fablabnbg/Innentueren/TechSpec/TechSpec_Innentueren.odt

FabLab Region Nürnberg

Innentüren

TechSpec

Changelog
Datum | Verfasser | Änderung
16.01.2019 | Roman | Erstentwurf
24.01.2019 | Mose, Gerhard, Schimmi | Änderungsvorschläge
31.01.2019 | Roman | Glattziehen des Kapitels Türmodul, Umzug ins Git

Synonym | Erklärung
Türserver | Der Rechner, welcher über die Türmodule mit den Lesereinheiten und dem Türöffner kommuniziert.
Türmodul | Die Hardware-Schnittstelle zwischen den Lesegeräten an der Tür und dem Türserver.
Lesereinheit | Die Elektronik an der Tür, welche die Karte einliest und mit dem Türmodul kommuniziert.
Türöffner | Oder auch Summer. Die elektromechanische Verriegelung der Tür.

1. Hardware
  1. Türmodul

Die gewählte Schnittstelle für die Innentüren ist UART. Da dies eine Punkt-zu-Punkt Verbindung ist, muss ein UART Hub eingesetzt werden, damit der Türserver mit begrenzten Schnittstellen auch mit allen Innentüren kommunizieren kann. Es wurde sich daher für eine 4er Granularität mit Hilfe des FTDI FT4232H Chips entschieden. Dieser Chip kann 4 UART Schnittstellen auf einen USB umsetzen.

Alle Module kommen in einem 19“ Rack unter und haben Eurokarten-Format (160x 100mm).

Die Backplane besteht aus DIN 41612 konformen Steckern. Die Stecker weisen 32 Pole auf (2 x 16 Pins).

Die Innentüren, der Server, die 4er Module sowie die Stromversorgung werden über diese Rückwand verteilt.

Es wird eine zusätzliche Platine für die Türmodul Frontplatte designed. Diese wird die LEDs und die Schalter mit der Hauptplatine verbinden. Die Verbindung wird über zwei 50-polige Wannenstecker (jeweils einer auf jeder Platine) und einem Breitbandkabel hergestellt.

Es werden pro Tür folgende Features benötigt:

- Status-LED für
  - TX
  - RX
  - Türöffner
  - Magnetkontakt
  - 5V Fuse OK LED für Logik Versorgungsspannung
  - 12V Fuse OK LED für Türöffner Versorgungsspannung
- Sicherungen
  - 5V (Logik)
  - 12V (Türöffner)
- Bedienelemente
  - Schalter „Ein-Aus-Ein“: Modi „Auto-Aus-Dauer Ein“, Ausführung Wechsler

Es werden pro Modul folgende Features benötigt:

- Status-LED für:
  - Modul Fehler (12V oder 5V Sicherung defekt)
  - 5V Spannungsversorgung Modul
  - 12V Spannungsversorgung Modul

Die RTS Leitung des jeweiligen UARTS steuert high-aktiv P-MOSFETs, die als High-Side Schalter eingesetzt werden. Auch die Freilaufdiode für den Türöffner wird auf der Platine vorgesehen. Während des Hochlaufs werden die RTS Leitungen durch den Power-Enable (früher UID) Pin auf GND gezogen. Beim Start der Innentüren-Applikation auf dem Türserver wird der Power-Enable GPIO Pin auf low geschaltet, somit werden die RTS Leitungen freigegeben.

Der Türöffner wird über die CTS Leitung seines UART Ports gesteuert.

Der Magnetkontakt kann über die CTS Leitung seines UARTs ausgelesen werden. Ein high Pegel bedeutet dabei „Tür offen“, low dementsprechend „Tür zu“.

Im Falle eines Ausfalls des Türservers müssen die Türen weiterhin zugänglich gemacht werden können. Über den beschriebenen 3 Wege Schalter können die einzelnen Türöffner dauerhaft bestromt, abgeschaltet oder in den Automatikmodus ( Normal ) geschalten werden.

Türserver (Review bitte von Schimmi, Gerhard oder Mose anfertigen.)

Als Türserver wird ein Raspberry Pi (Modell ?) verwendet, der ebenfalls auf eine Europakarte im Einschubmodul montiert wird. Versorgungsspannung und Interfaceleitungen erfolgen über den Backplane Bus, der Ethernetanschluß kommt auf die Frontplatte.

Der Server muss auch ohne Netzwerkverbindung booten können und die volle Funktionalität der Türzentrale bereitstellen, dann ggf. mit einem älteren Stand der Zugangsberechtigungen.

Nach einem regulären Boot (oder Reset) wird zunächst ein Health-Check der angeschlossenen Türmodule und Türeinheiten durchgeführt. Dann wird versucht den aktuellen Stand der Zugangsberechtigungen von einem Server (bitte näher definieren!) abzuholen; schlägt dies fehl geht der Server mit dem vorhandenen Stand in Betrieb.

Der Betriebszustand wird über eine LED an der Frontplatte signalisiert.

Durch einen Taster an der Frontplatte kann ein Reset ausgelöst werden.

Durch einen weiteren Taster an der Frontplatte kann ein Health-Check getriggert werden.

Taster für Reboot ?

Config-File: Die Zugangsberechtigungen werden aus einem Config-File gelesen. Das ist eine Matrix aus Kartennummern und Türstationen. Neben den Zugangsberechtigungen muss in diesem Config-File (oder einem anderen?) auch die vorhandene Hardware hinterlegt sein, also wie viele Türmodule existieren, und welche Türschnittstellen je Modul belegt sind.

Health-Check: Hier wird auf Vorhandensein und Basis-Funktion der laut Config-File zu existierenden Komponenten getestet.

Step 1: USB-Kommunikation mit den 1 – n Türmodulen. Hier könnte z.B. die UID-LED am Türmodul angesprochen werden. (Bitte näher spezifizieren!)

Step 2: UART-Kommunikation mit den Lesereinheiten, die der Reihe nach angesprochen werden und im einfachsten Fall mit „ich bin da“ antworten. (Bitte näher spezifizieren!)

Wenn alles funktioniert leuchtet anschließend eine grüne LED an der Frontplatte, die bleibt auch im Normalbetrieb an.

Wenn in einem Step ein Fehler auftritt blinkt eine rote LED.

Wie der Bediener dann herausfindet, was genau fehlgeschlagen ist wäre noch zu klären.

Türserver Hardware: Optional könnten wir den Raspi mit einer SSD (mit USB-SATA Adapter) ausstatten und uns damit von den fehleranfälligen MicroSD Karten unabhängig machen. Sollten wir bei der mechanischen Konzeption des Türserver-Moduls bereits vorsehen.

Alternativ USB-Memorystick. Micro-SD Karte Read only. Datenbank kann bei Fehlern des R/W-Speichers solangen Sie vom Netz geholt werden kann in Ramdisk abgelegt werden.

Schreiben auf die Micro-SD-Karte maximal verhindern.

Lesereinheit (Review bitte von Schimmi anfertigen)

An jeder Tür befindet sich eine Lesereinheit bestehend aus:

• RFID-Kartenleser
• Türöffner
• Magnetkontakt (Tür geschlossen?)
• LED zur Betriebsanzeige (Vcc)
• RGB LED zur Statusanzeige
• Lautsprecher ~~Buzzer~~ für Audiofeedback
• CPU zur UART-Kommunikation (vermutlich Arduino?)

Bis auf den Türöffner (und Magnetkontakt?) sollten alle Komponenten eine kompakte Einheit bilden die leicht zu montieren und austauschen ist.

Alle Lesereinheiten sind identisch und beinhalten keine türspezifischen Komponenten oder Konfigurationen (DIP-Switches, Jumper o.ä.).

Die Verkabelung zur Lesereinheit erfolgt mit CAT-7 Verlegekabel, ein Aderpäarchen ist für den Türöffner reserviert. Anschluss und Position des Magnetkontaktes ist noch zu definieren.

Weitere Spezifikation muss noch durch Schimmi2 erfolgen.

Bitte auch die Blockschaltbilder für Türmodul und Lesereinheit unter https://oc.fablab-nuernberg.de/index.php/apps/files/?dir=/_intern/Projekte/000208-Innentueren/Türmodul/ (https://oc.fablab-nuernberg.de/index.php/apps/files/?fileid=302718)TechInfo&fileid=302718 (https://oc.fablab-nuernberg.de/index.php/apps/files/?fileid=302718) mit Kommentaren versehen, ich aktualisiere die dann entsprechend.
