fablabnbg/Innentueren/CAD/Tuermodul/Tuermodul.ods

Sheet: Tuermodul_bearbeitet
Source: | C:\Users\Roman\Dropbox\Projekte\FabLab\Innentueren\Innentueren\CAD\Tuermodul\Tuermodul.sch
Date: | 31.03.2019 16:09
Tool: | Eeschema (5.0.2)-1
Generator: | C:\Program Files\KiCad\bin\scripting\plugins/bom_csv_grouped_by_value.py
Component Count: | 176
 | Farb-Legende
 |  | Haben wir im Lab
 |  | Haben wir evtl.
 |  | Müssen wir bestellen
Item | Qty | Reference(s) | Value | LibPart | Footprint
1 | 2 | C101, C102 | 1u | Device:CP_Small | Capacitor_THT:CP_Radial_D5.0mm_P2.00mm |  | gefunden
2 | 14 | C103, C108, C110, C111, C112, C113, C114, C115, C116, C117, C118, C119, C120, C121 | 100n | Device:C_Small | Capacitor_SMD:C_0603_1608Metric_Pad1.05x0.95mm_HandSolder
3 | 2 | C104, C105 | 27p | Device:C_Small | Capacitor_SMD:C_0603_1608Metric_Pad1.05x0.95mm_HandSolder
4 | 1 | C106 | 3u3 | Device:C_Small | Capacitor_SMD:C_0805_2012Metric_Pad1.15x1.40mm_HandSolder
5 | 2 | C107, C109 | 4u7 | Device:CP_Small | Capacitor_THT:CP_Radial_D5.0mm_P2.50mm |  | gefunden
6 | 4 | D201, D202, D203, D204 | 1N4007 | Diode:1N4007 | Diode_THT:D_DO-41_SOD81_P10.16mm_Horizontal |  | gefunden
7 | 10 | D205, D206, D207, D208, D209, D210, D211, D212, D213, D214 | 1N4148 | Device:D_Small | Diode_THT:D_DO-41_SOD81_P7.62mm_Horizontal |  | gefunden
8 | 23 | D301, D303, D304, D305, D307, D308, D309, D311, D312, D313, D315, D316, D317, D319, D320, D321, D322, D323, D324, D325, D326, D327, D328 | rt | Device:LED_Small | LED_THT:LED_D3.0mm |  | gefunden
9 | 4 | D306, D310, D314, D318 | gn | Device:LED_Small | LED_THT:LED_D3.0mm |  | gefunden
10 | 4 | F201, F202, F203, F204 | 1A | Device:Fuse_Small | Fuse:Fuseholder_Cylinder-5x20mm_Schurter_0031_8201_Horizontal_Open
11 | 4 | F205, F206, F207, F208 | 0.5A | Device:Fuse_Small | Fuse:Fuseholder_Cylinder-5x20mm_Schurter_0031_8201_Horizontal_Open
12 | 1 | J101 | Conn_02x16_Counter_Clockwise | Connector_Generic:Conn_02x16_Counter_Clockwise | DIN41612_Connectors_custom:DIN41612_D_32pol_90deg |  | gefunden
13 | 1 | J201 | Conn_02x20_Odd_Even | Connector_Generic:Conn_02x20_Odd_Even | Connector_PinSocket_2.54mm:PinSocket_2x20_P2.54mm_Vertical_SMD
14 | 4 | J202, J203, J204, J205 | Conn_02x01 | Connector_Generic:Conn_02x01 | Connector_PinHeader_2.54mm:PinHeader_2x01_P2.54mm_Vertical |  | gefunden
15 | 1 | J301 | Conn_02x20_Counter_Clockwise | Connector_Generic:Conn_02x20_Odd_Even | Connector_PinSocket_2.54mm:PinSocket_2x20_P2.54mm_Vertical_SMD
16 | 2 | L101, L102 | 600R/0.5A | Device:L_Core_Ferrite_Small | Inductor_SMD:L_0603_1608Metric_Pad1.05x0.95mm_HandSolder
17 | 9 | Q205, Q206, Q207, Q208, Q213, Q214, Q215, Q216, Q301 | Q_NPN_CBE | Device:Q_NPN_CBE | Package_TO_SOT_THT:TO-92_HandSolder
18 | 4 | Q209, Q210, Q211, Q212 | Q_PMOS_GDS | Device:Q_PMOS_GDS | Package_TO_SOT_THT:TO-220-3_Vertical
19 | 19 | R101, R120, R121, R122, R123, R206, R207, R208, R214, R215, R216, R217, R220, R221, R223, R225, R226, R301, R304 | 1k | Device:R_Small | Resistor_SMD:R_0603_1608Metric_Pad1.05x0.95mm_HandSolder |  | gefunden
20 | 1 | R102 | 12k | Device:R_Small | Resistor_SMD:R_0603_1608Metric_Pad1.05x0.95mm_HandSolder |  | gefunden
21 | 5 | R103, R115, R117, R119, R205 | 10k | Device:R_Small | Resistor_SMD:R_0603_1608Metric_Pad1.05x0.95mm_HandSolder |  | gefunden
22 | 8 | R104, R105, R107, R108, R110, R111, R113, R114 | 33R | Device:R_Small | Resistor_SMD:R_0603_1608Metric_Pad1.05x0.95mm_HandSolder |  | gefunden
23 | 4 | R106, R109, R112, R118 | 100R | Device:R_Small | Resistor_SMD:R_0603_1608Metric_Pad1.05x0.95mm_HandSolder |  | gefunden
24 | 1 | R116 | 2k | Device:R_Small | Resistor_SMD:R_0603_1608Metric_Pad1.05x0.95mm_HandSolder |  | gefunden
25 | 4 | R201, R202, R203, R204 | 1k | Device:R_Small | Resistor_THT:R_Axial_DIN0207_L6.3mm_D2.5mm_P7.62mm_Horizontal |  | gefunden | 0,25W
26 | 4 | R209, R210, R211, R212 | 100k | Device:R_Small | Resistor_THT:R_Axial_DIN0207_L6.3mm_D2.5mm_P7.62mm_Horizontal |  | gefunden | 0,25W
27 | 2 | R213, R219 | 1M | Device:R_Small | Resistor_THT:R_Axial_DIN0207_L6.3mm_D2.5mm_P7.62mm_Horizontal |  | gefunden
28 | 3 | R218, R224, R228 | 10k | Device:R_Small | Resistor_THT:R_Axial_DIN0207_L6.3mm_D2.5mm_P7.62mm_Horizontal |  | gefunden | 0,25W
29 | 2 | R302, R303 | 330R | Device:R_Small | Resistor_SMD:R_0603_1608Metric_Pad1.05x0.95mm_HandSolder |  | gefunden
30 | 8 | R305, R306, R307, R308, R309, R310, R311, R312 | 4k7 | Device:R_Small | Resistor_SMD:R_0603_1608Metric_Pad1.05x0.95mm_HandSolder |  | gefunden
31 | 4 | R313, R314, R315, R316 | 470R | Device:R_Small | Resistor_SMD:R_0603_1608Metric_Pad1.05x0.95mm_HandSolder
32 | 8 | R317, R318, R319, R320, R321, R322, R323, R324 | 0 | Device:R_Small | Resistor_SMD:R_0603_1608Metric_Pad1.05x0.95mm_HandSolder |  | nicht benötigt
33 | 2 | RN201, RN202 | 4x10k | Device:R_Network04 | Resistor_THT:R_Array_SIP5 |  | nicht vorhanden
34 | 4 | SW301, SW302, SW303, SW304 | SW_SPDT_MSM | Switch:SW_SPDT_MSM | Switches:SPDT
35 | 1 | U101 | 93LC46B | Memory_EEPROM:93LCxxB | Package_SO:SOIC-8_3.9x4.9mm_P1.27mm
36 | 1 | U102 | 74HC595 | 74xx:74HC595 | Package_DIP:DIP-16_W7.62mm_Socket_LongPads |  | MC74HC595N ???
37 | 1 | U103 | FT4232H | Interface_USB:FT4232H | Package_QFP:LQFP-64_10x10mm_P0.5mm
38 | 1 | U104 | MCP1825S | Regulator_Linear:MCP1825S | Package_TO_SOT_THT:TO-220-3_Vertical
39 | 1 | Y101 | 12MHz | Device:Crystal_Small | Crystal:Crystal_HC18-U_Vertical
 |  |  |  |  |  |  | Nachbestellung Reichelt
Anzahl Pro Platine | Gesamt | Wert | Bauform |  | Reichelt Nr. | Digikey Teilenummer
14 | 70 | 100n | 0603 | Capacitor_SMD:C_0603_1608Metric_Pad1.05x0.95mm_HandSolder | X7R-G0603 100N
2 | 10 | 27p | 0603 | Capacitor_SMD:C_0603_1608Metric_Pad1.05x0.95mm_HandSolder | KEM C0G0603 27P
1 | 5 | 3u3 | 0805 | Capacitor_SMD:C_0805_2012Metric_Pad1.15x1.40mm_HandSolder | / | 1276-6461-1-ND (https://www.digikey.de/product-detail/de/samsung-electro-mechanics/CL21A335KPFNNNG/1276-6461-1-ND/5958089)
8 | 40 | 1A | Fuse:Fuseholder_Cylinder-5x20mm_Schurter_0031_8201_Horizontal_Open | Fuse:Fuseholder_Cylinder-5x20mm_Schurter_0031_8201_Horizontal_Open | PL OGN-22,5
2 | 10 | Conn_02x20_Odd_Even | 2x20 2,54mm SMD Stiftleiste | Connector_PinSocket_2.54mm:PinSocket_2x20_P2.54mm_Vertical_SMD | MPE 087-2-040 |  | SL 2X20G SMD2,54
2 | 10 | 600R/0.5A | 0603 | Inductor_SMD:L_0603_1608Metric_Pad1.05x0.95mm_HandSolder | BLM18AG 601
9 | 45 | Q_NPN_CBE | TO-92 | Package_TO_SOT_THT:TO-92_HandSolder | BC 547C
4 | 20 | Q_PMOS_GDS | TO-220 | Package_TO_SOT_THT:TO-220-3_Vertical | IRF 9510
4 | 20 | 470R | 0603 | Resistor_SMD:R_0603_1608Metric_Pad1.05x0.95mm_HandSolder | VIS CRCW0603470 (https://www.reichelt.de/smd-widerstand-0603-470-ohm-100-mw-1-vis-crcw0603470-p238048.html?trstct=pol_2)
2 | 10 | 4x10k | SIP5 R-Network | Resistor_THT:R_Array_SIP5 | SIL 5-4-10K |  | SIL 5-4-10K
4 | 20 | SW_SPDT_MSM | Reichelt: MS500C | Switches:SPDT | MS 500C
1 | 5 | 93LC46B | SOIC-8 | Package_SO:SOIC-8_3.9x4.9mm_P1.27mm | 93LC46B-I/SN
1 | 5 | FT4232H | LQFP-64 10x10mm P=0.5mm | Package_QFP:LQFP-64_10x10mm_P0.5mm | / | 768-1026-1-ND (https://www.digikey.de/product-detail/de/ftdi-future-technology-devices-international-ltd/FT4232HL-REEL/768-1026-1-ND/1986059)
1 | 5 | MCP1825S | TO-220 | Package_TO_SOT_THT:TO-220-3_Vertical | LM3940 IT3,3
1 | 5 | 12MHz | HC18/U | Crystal:Crystal_HC18-U_Vertical | 12,0000-HC18
2 | 10 | 02x20 Buchsenleiste auf Breitbandkabel | 02x20 2,54mm |  | / | HHKC20H-ND (https://www.digikey.de/product-detail/de/assmann-wsw-components/AWP-20-7240-T/HHKC20H-ND/4864473) | PFL 40
 |  |  |  |  |  |  | gefunden
 |  |  |  |  |  |  | gefunden
 |  |  |  |  |  |  | gefunden
 |  |  |  |  |  |  | gefunden
 |  |  |  |  |  |  | gefunden
 |  |  |  |  |  |  | gefunden
 |  |  |  |  |  |  | gefunden
 |  |  |  |  |  |  | gefunden
 |  |  |  |  |  |  | nicht benötigt
 |  |  |  |  |  | Datasheet
 |  |  |  |  |  | ~
 |  |  |  |  |  | ~
 |  |  |  |  |  | ~
 |  |  |  |  |  | ~
 |  |  |  |  |  | ~
 |  |  |  |  |  | http://www.vishay.com/docs/88503/1n4001.pdf
 |  |  |  |  |  | ~
 |  |  |  |  |  | ~
 |  |  |  |  |  | ~
 |  |  |  |  |  | ~
 |  |  |  |  |  | ~
 |  |  |  |  |  | ~
 |  |  |  |  |  | ~
 |  |  |  |  |  | ~
 |  |  |  |  |  | ~
 |  |  |  |  |  | ~
 |  |  |  |  |  | ~
 |  |  |  |  |  | ~
 |  |  |  |  |  | ~
 |  |  |  |  |  | ~
 |  |  |  |  |  | ~
 |  |  |  |  |  | ~
 |  |  |  |  |  | ~
 |  |  |  |  |  | ~
 |  |  |  |  |  | ~
 |  |  |  |  |  | ~
 |  |  |  |  |  | ~
 |  |  |  |  |  | ~
 |  |  |  |  |  | ~
 |  |  |  |  |  | ~
 |  |  |  |  |  | ~
 |  |  |  |  |  | ~
 |  |  |  |  |  | http://www.vishay.com/docs/31509/csc.pdf
 |  |  |  |  |  | http://ww1.microchip.com/downloads/en/DeviceDoc/20001749K.pdf
 |  |  |  |  |  | http://www.ti.com/lit/ds/symlink/sn74hc595.pdf
 |  |  |  |  |  | http://ww1.microchip.com/downloads/en/devicedoc/22056b.pdf
 |  |  |  |  |  | ~

Sheet: Tabelle1
1 | 2 | 14 | C103, C108, C110, C111, C112, C113, C114, C115, C116, C117, C118, C119, C120, C121 | 100n | Device:C_Small | Capacitor_SMD:C_0603_1608Metric_Pad1.05x0.95mm_HandSolder
2 | 3 | 2 | C104, C105 | 27p | Device:C_Small | Capacitor_SMD:C_0603_1608Metric_Pad1.05x0.95mm_HandSolder
 | 4 | 1 | C106 | 3u3 | Device:C_Small | Capacitor_SMD:C_0805_2012Metric_Pad1.15x1.40mm_HandSolder
 | 16 | 2 | L101, L102 | 600R/0.5A | Device:L_Core_Ferrite_Small | Inductor_SMD:L_0603_1608Metric_Pad1.05x0.95mm_HandSolder
3 | 19 | 19 | R101, R120, R121, R122, R123, R206, R207, R208, R214, R215, R216, R217, R220, R221, R223, R225, R226, R301, R304 | 1k | Device:R_Small | Resistor_SMD:R_0603_1608Metric_Pad1.05x0.95mm_HandSolder
4 | 20 | 1 | R102 | 12k | Device:R_Small | Resistor_SMD:R_0603_1608Metric_Pad1.05x0.95mm_HandSolder
 | 24 | 1 | R116 | 2k | Device:R_Small | Resistor_SMD:R_0603_1608Metric_Pad1.05x0.95mm_HandSolder
 | 29 | 2 | R302, R303 | 330R | Device:R_Small | Resistor_SMD:R_0603_1608Metric_Pad1.05x0.95mm_HandSolder
5 | 21 | 5 | R103, R115, R117, R119, R205 | 10k | Device:R_Small | Resistor_SMD:R_0603_1608Metric_Pad1.05x0.95mm_HandSolder
6 | 22 | 8 | R104, R105, R107, R108, R110, R111, R113, R114 | 33R | Device:R_Small | Resistor_SMD:R_0603_1608Metric_Pad1.05x0.95mm_HandSolder
7 | 23 | 4 | R106, R109, R112, R118 | 100R | Device:R_Small | Resistor_SMD:R_0603_1608Metric_Pad1.05x0.95mm_HandSolder
8 | 30 | 8 | R305, R306, R307, R308, R309, R310, R311, R312 | 4k7 | Device:R_Small | Resistor_SMD:R_0603_1608Metric_Pad1.05x0.95mm_HandSolder
9 | 31 | 4 | R313, R314, R315, R316 | 470R | Device:R_Small | Resistor_SMD:R_0603_1608Metric_Pad1.05x0.95mm_HandSolder
10 | 32 | 8 | R317, R318, R319, R320, R321, R322, R323, R324 | 0 | Device:R_Small | Resistor_SMD:R_0603_1608Metric_Pad1.05x0.95mm_HandSolder
11 | 35 | 1 | U101 | 93LC46B | Memory_EEPROM:93LCxxB | Package_SO:SOIC-8_3.9x4.9mm_P1.27mm
12 | 37 | 1 | U103 | FT4232H | Interface_USB:FT4232H | Package_QFP:LQFP-64_10x10mm_P0.5mm
1 | 2 | C101, C102 | 1u | Device:CP_Small | Capacitor_THT:CP_Radial_D5.0mm_P2.00mm |  | gefunden
5 | 2 | C107, C109 | 4u7 | Device:CP_Small | Capacitor_THT:CP_Radial_D5.0mm_P2.50mm |  | gefunden
6 | 4 | D201, D202, D203, D204 | 1N4007 | Diode:1N4007 | Diode_THT:D_DO-41_SOD81_P10.16mm_Horizontal |  | gefunden
7 | 10 | D205, D206, D207, D208, D209, D210, D211, D212, D213, D214 | 1N4148 | Device:D_Small | Diode_THT:D_DO-41_SOD81_P7.62mm_Horizontal |  | gefunden
10 | 4 | F201, F202, F203, F204 | 1A | Device:Fuse_Small | Fuse:Fuseholder_Cylinder-5x20mm_Schurter_0031_8201_Horizontal_Open
11 | 4 | F205, F206, F207, F208 | 0.5A | Device:Fuse_Small | Fuse:Fuseholder_Cylinder-5x20mm_Schurter_0031_8201_Horizontal_Open
17 | 9 | Q205, Q206, Q207, Q208, Q213, Q214, Q215, Q216, Q301 | Q_NPN_CBE | Device:Q_NPN_CBE | Package_TO_SOT_THT:TO-92_HandSolder
18 | 4 | Q209, Q210, Q211, Q212 | Q_PMOS_GDS | Device:Q_PMOS_GDS | Package_TO_SOT_THT:TO-220-3_Vertical
25 | 4 | R201, R202, R203, R204 | 1k | Device:R_Small | Resistor_THT:R_Axial_DIN0207_L6.3mm_D2.5mm_P7.62mm_Horizontal |  | gefunden | 0,25W
26 | 4 | R209, R210, R211, R212 | 100k | Device:R_Small | Resistor_THT:R_Axial_DIN0207_L6.3mm_D2.5mm_P7.62mm_Horizontal |  | gefunden | 0,25W
27 | 2 | R213, R219 | 1M | Device:R_Small | Resistor_THT:R_Axial_DIN0207_L6.3mm_D2.5mm_P7.62mm_Horizontal |  | gefunden
28 | 3 | R218, R224, R228 | 10k | Device:R_Small | Resistor_THT:R_Axial_DIN0207_L6.3mm_D2.5mm_P7.62mm_Horizontal |  | gefunden | 0,25W
33 | 2 | RN201, RN202 | 4x10k | Device:R_Network04 | Resistor_THT:R_Array_SIP5 |  | nicht vorhanden
36 | 1 | U102 | 74HC595 | 74xx:74HC595 | Package_DIP:DIP-16_W7.62mm_Socket_LongPads |  | MC74HC595N ???
38 | 1 | U104 | MCP1825S | Regulator_Linear:MCP1825S | Package_TO_SOT_THT:TO-220-3_Vertical
