fablabnbg/Innentueren/Kartenleser/Mechanik/KartenleserSCAD.stl

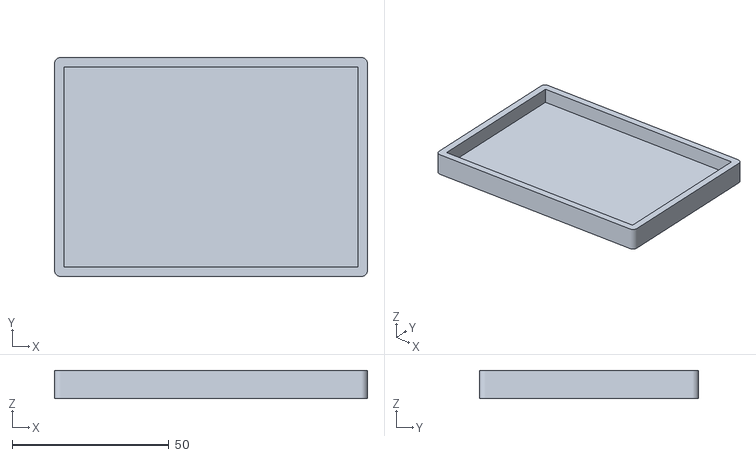
[picture p1: CAD file, 2020-03-15]
Kartenleser/Mechanik/KartenleserSCAD.stl
100.0 x 70.0 x 9.00
