fablabnbg/Innentueren/Kartenleser/Doku/Leserbefehle.pdf

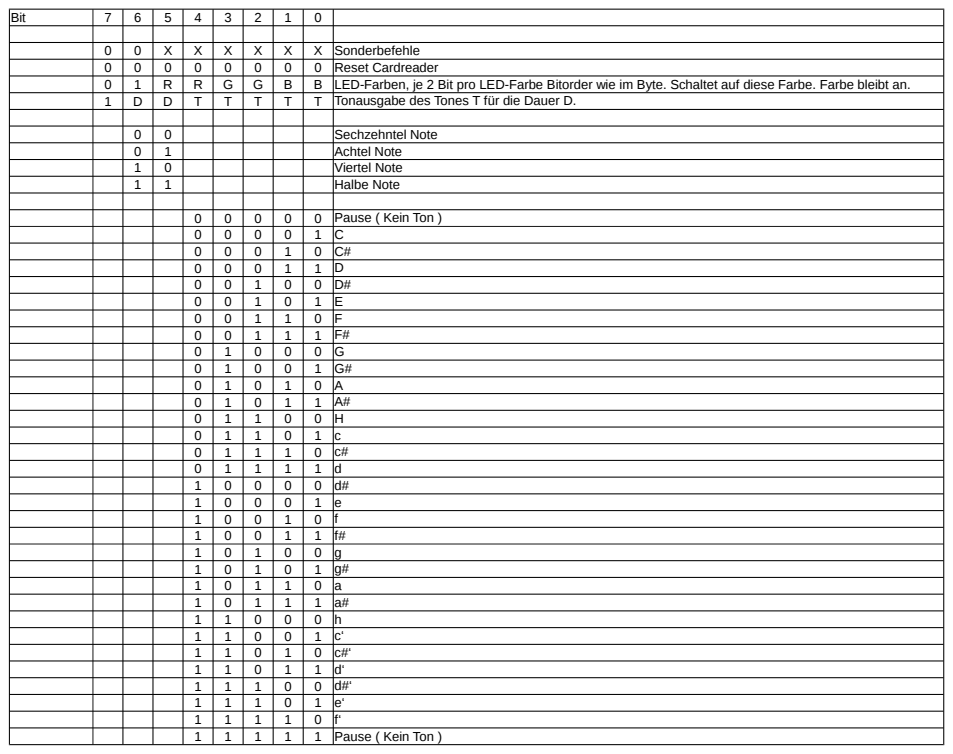
[picture p2: page 1]
Bit; X Sonderbefehle; 0 Reset Cardreader; B LED-Farben, je 2 Bit pro LED-Farbe Bitorder wie im Byte. Schaltet auf diese Farbe. Farbe bleibt an.; T Tonausgabe des Tones T für die Dauer D.; Sechzehntel Note; Achtel Note; Viertel Note; Halbe Note; 0 Pause ( Kein Ton ); 1 Pause ( Kein Ton )

Zum Binken ohne Ton wird eine Farbe eingeschaltet, eine Pause der gewünschten Länge gespielt und dann die nächste Farbe zum Blinken ausgegeben Zum Blinken mit Ton wird anstelle der Pause der gewünschte Ton in der gewünschten Länge nach dem Einschalten der Farbe ausgegeben.
Zum Ausschalten der LEDs muss 0b01000000 = 0x40 = ASCII @ ausgegeben werden.
Beispiele: 0x42 0xF6 0x40 0xFB 0x42 0xF6 0x40 0xFB Martinshorn mit Blaulicht
