fablabnbg/Innentueren/Kartenleser/Hardware/Cardreader_522/Cardreader_522.sch.pdf

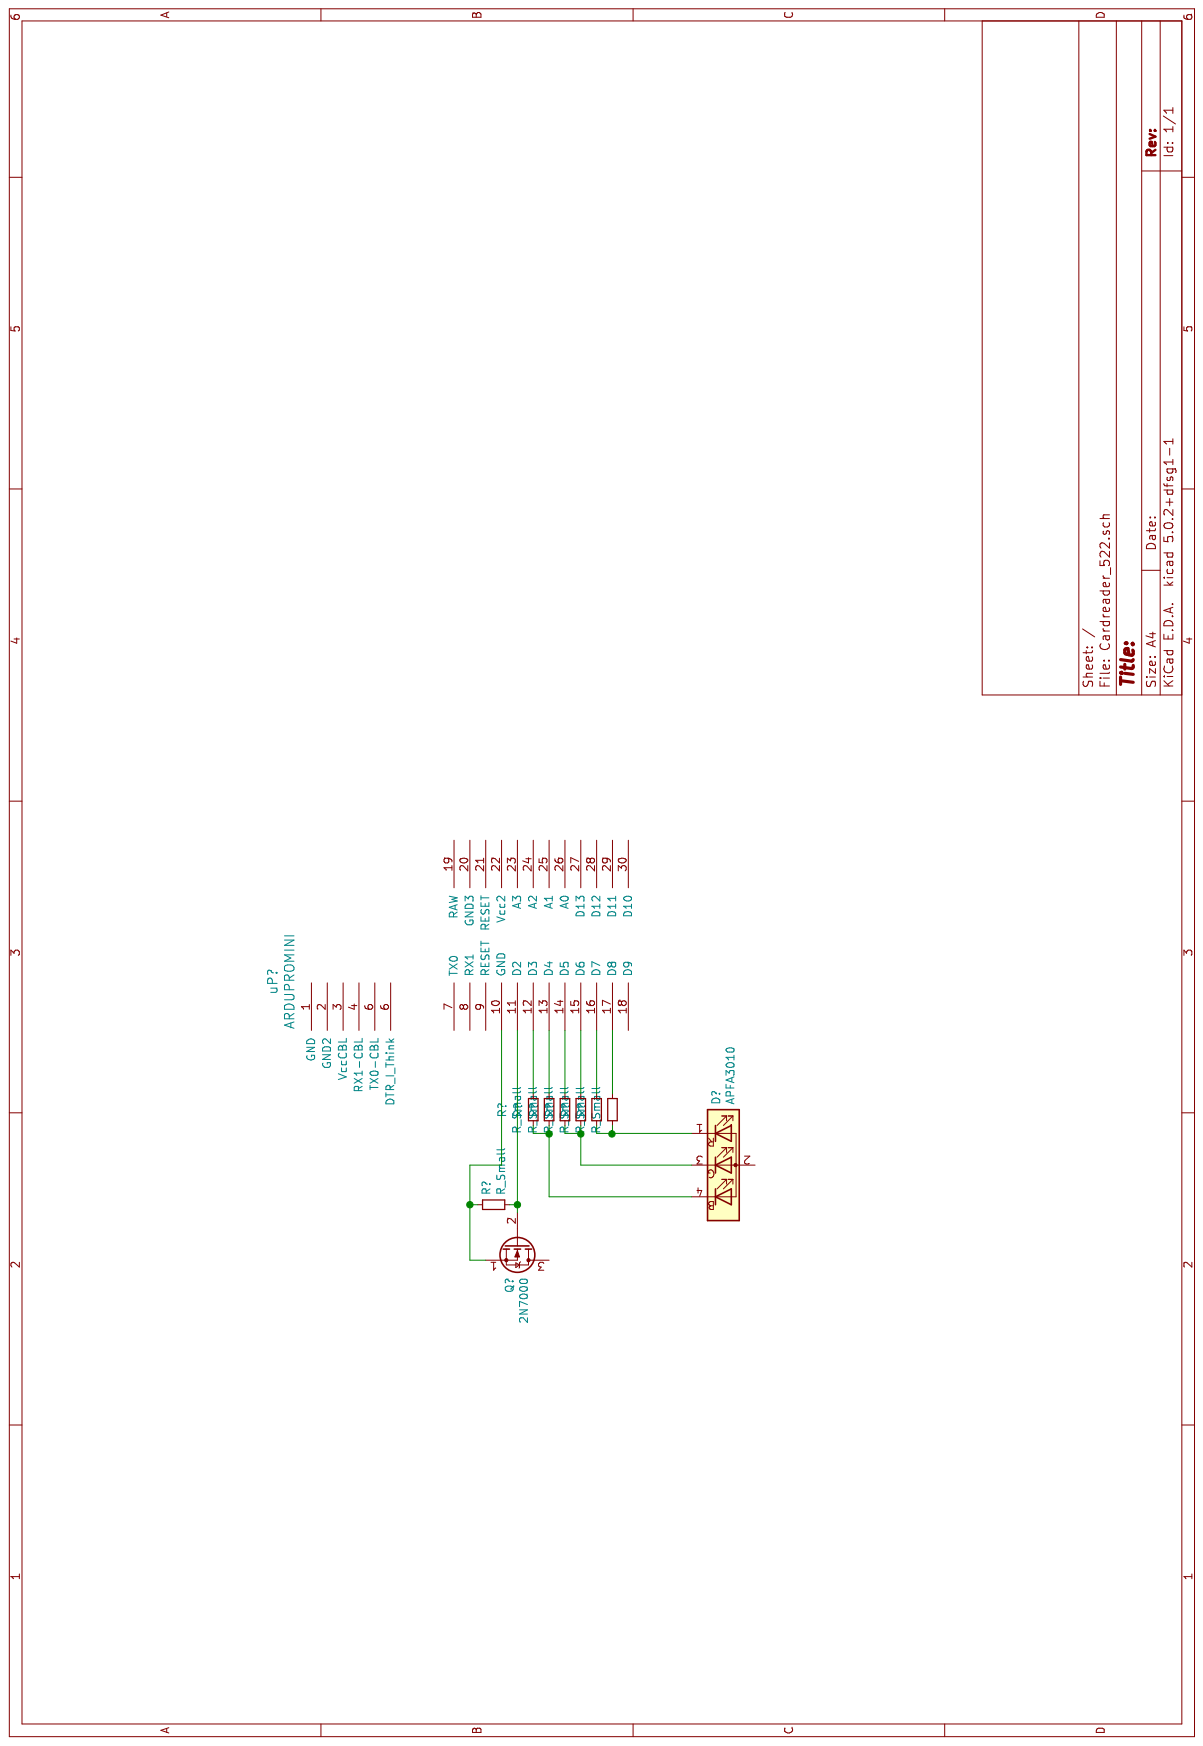
[picture p3: page 1]
