fablabnbg/Innentueren/CAD/Raspi_Innentueren/Raspi_Innentueren.pcb.pdf

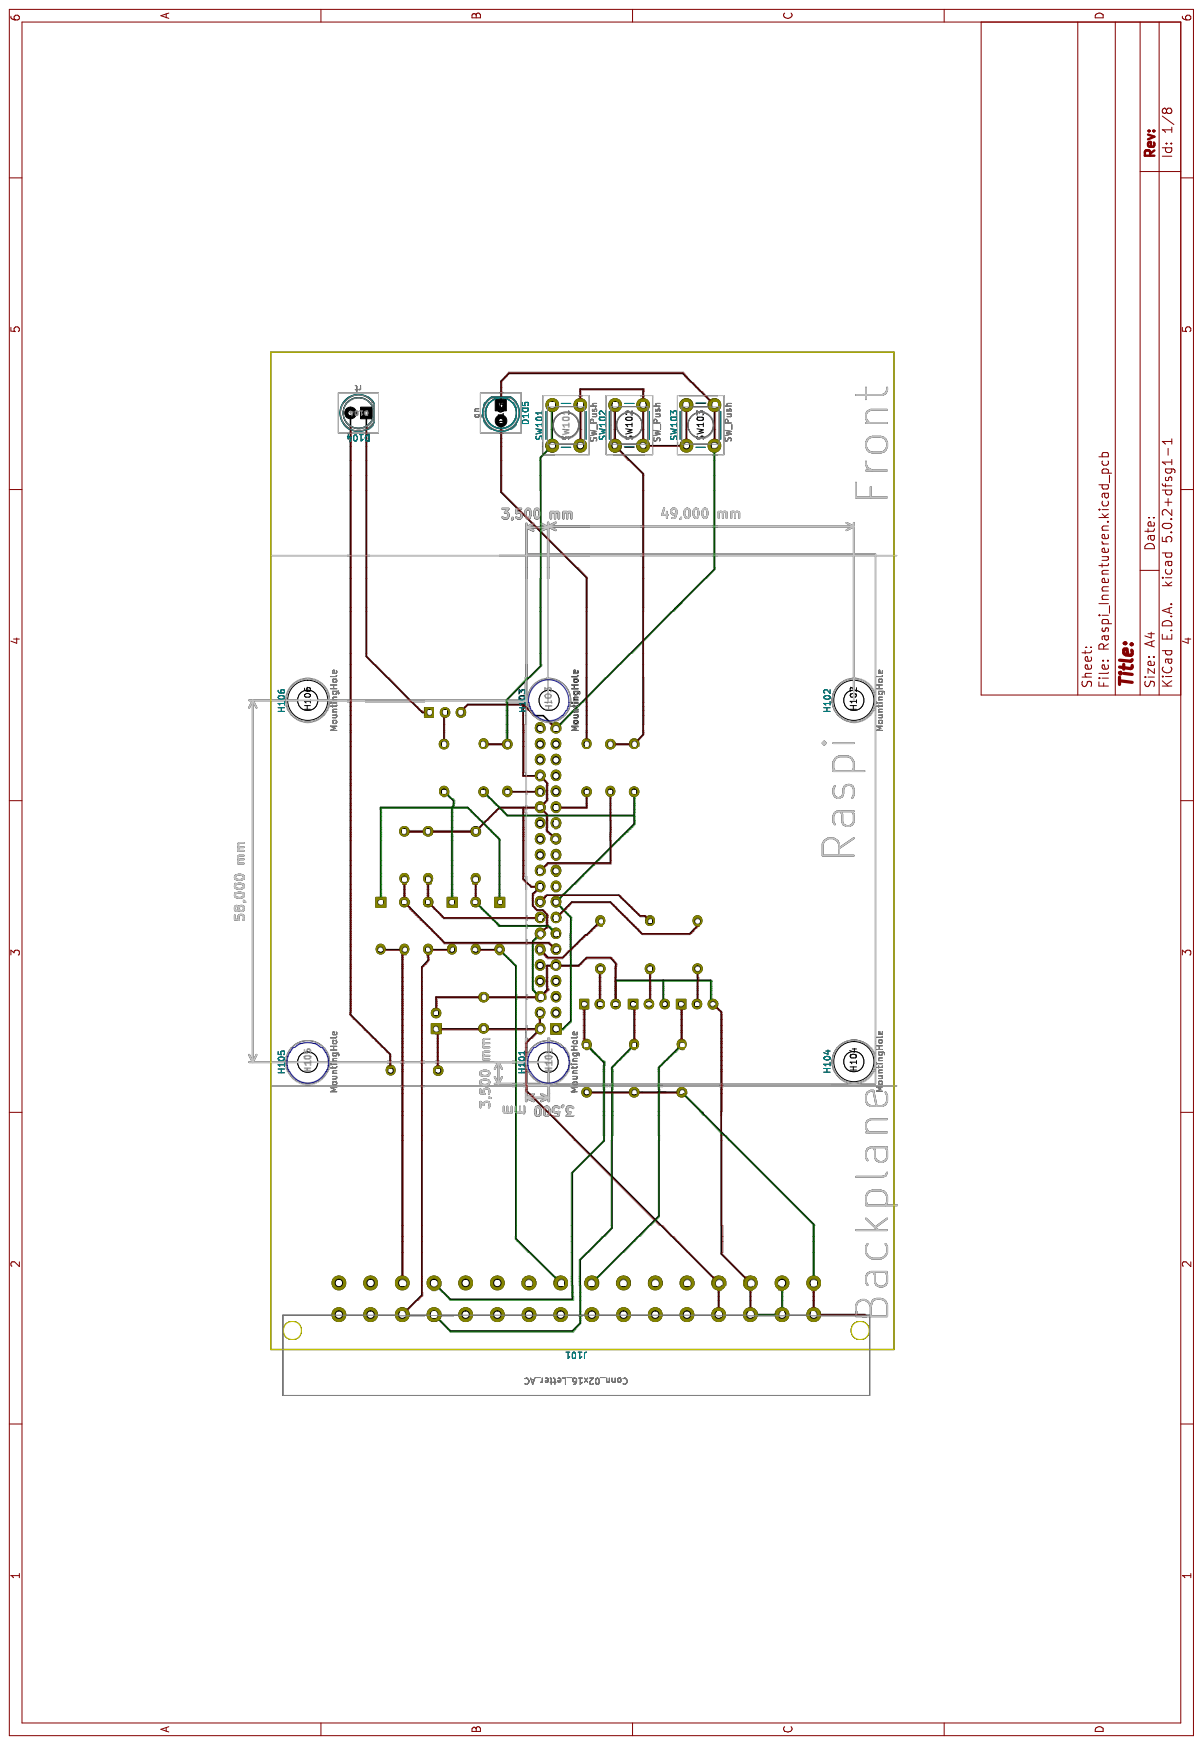
[picture p4: page 1]
