fablabnbg/Innentueren/CAD/Raspi_Innentueren/Raspi_Innentueren.sch.pdf

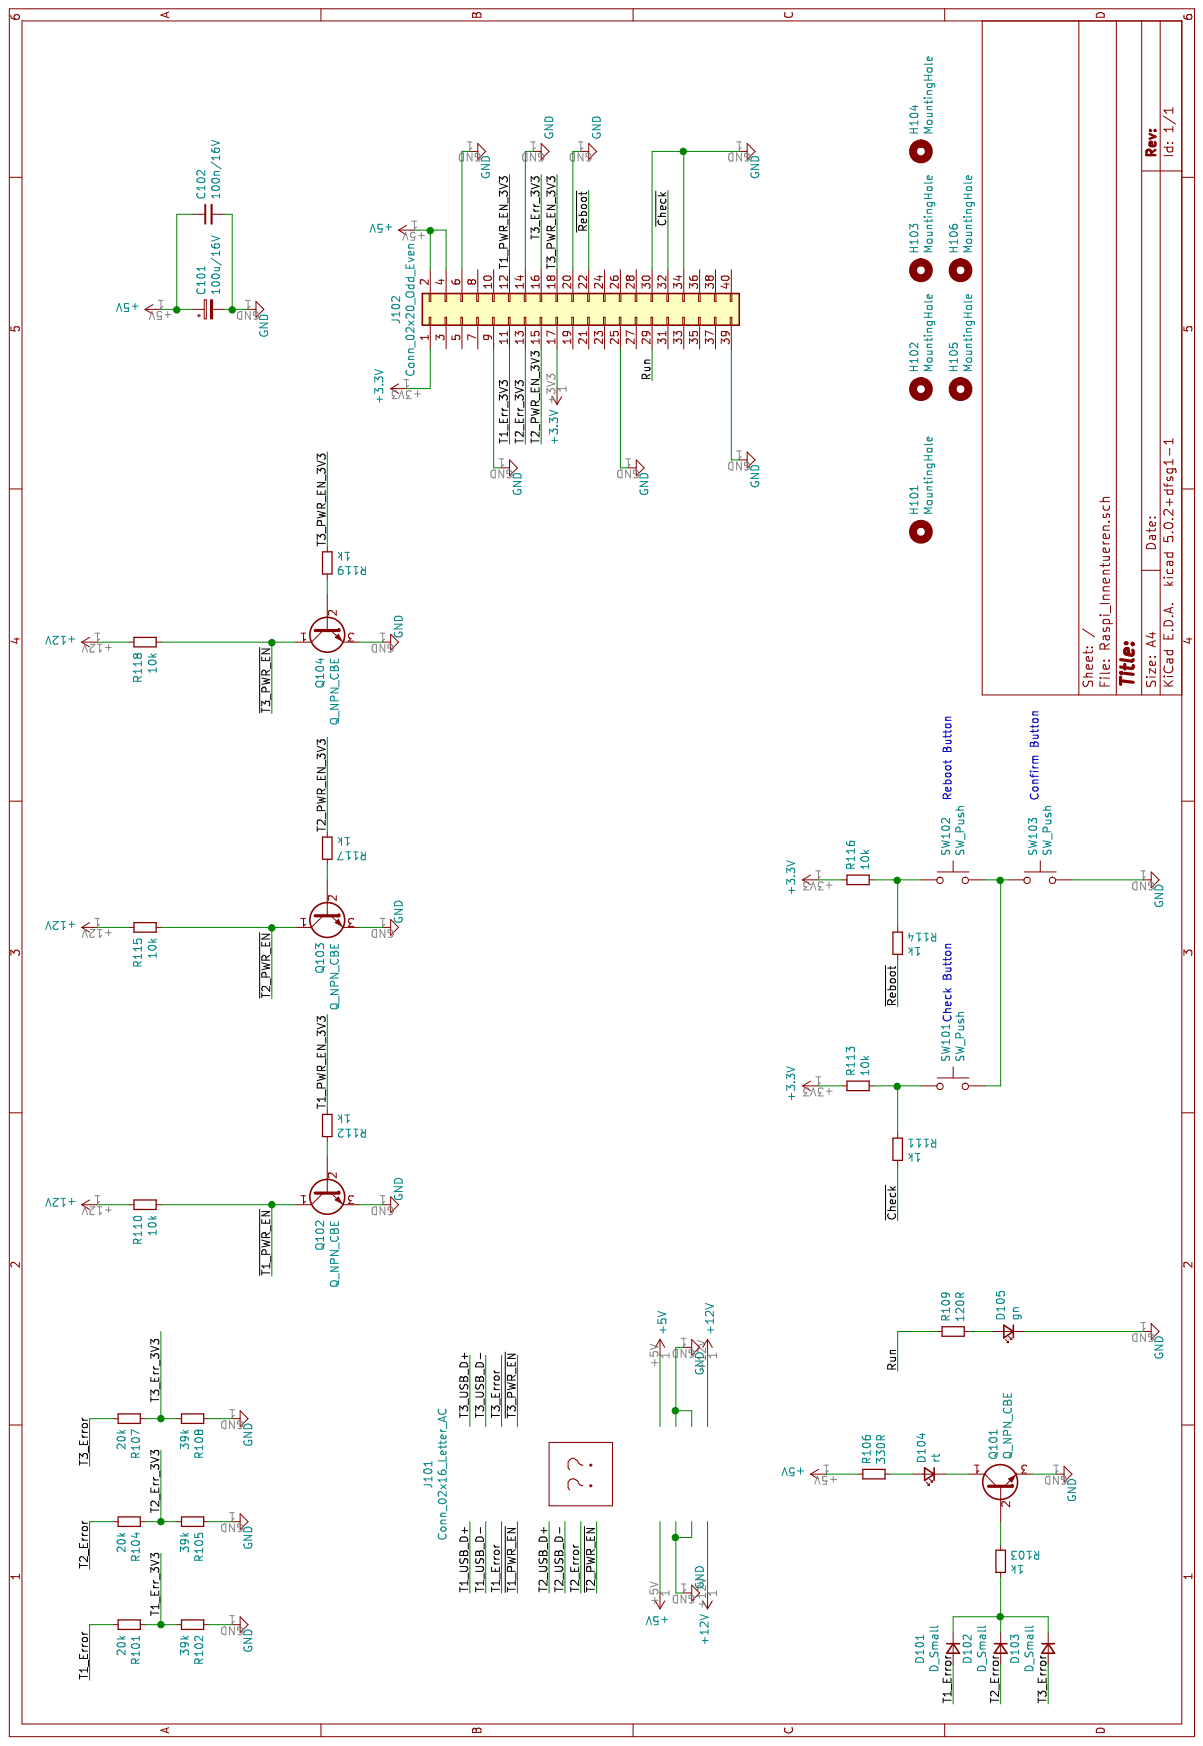
[picture p5: page 1]
