fablabnbg/Innentueren/CAD/Tuermodul/Tuermodul.pcb.pdf

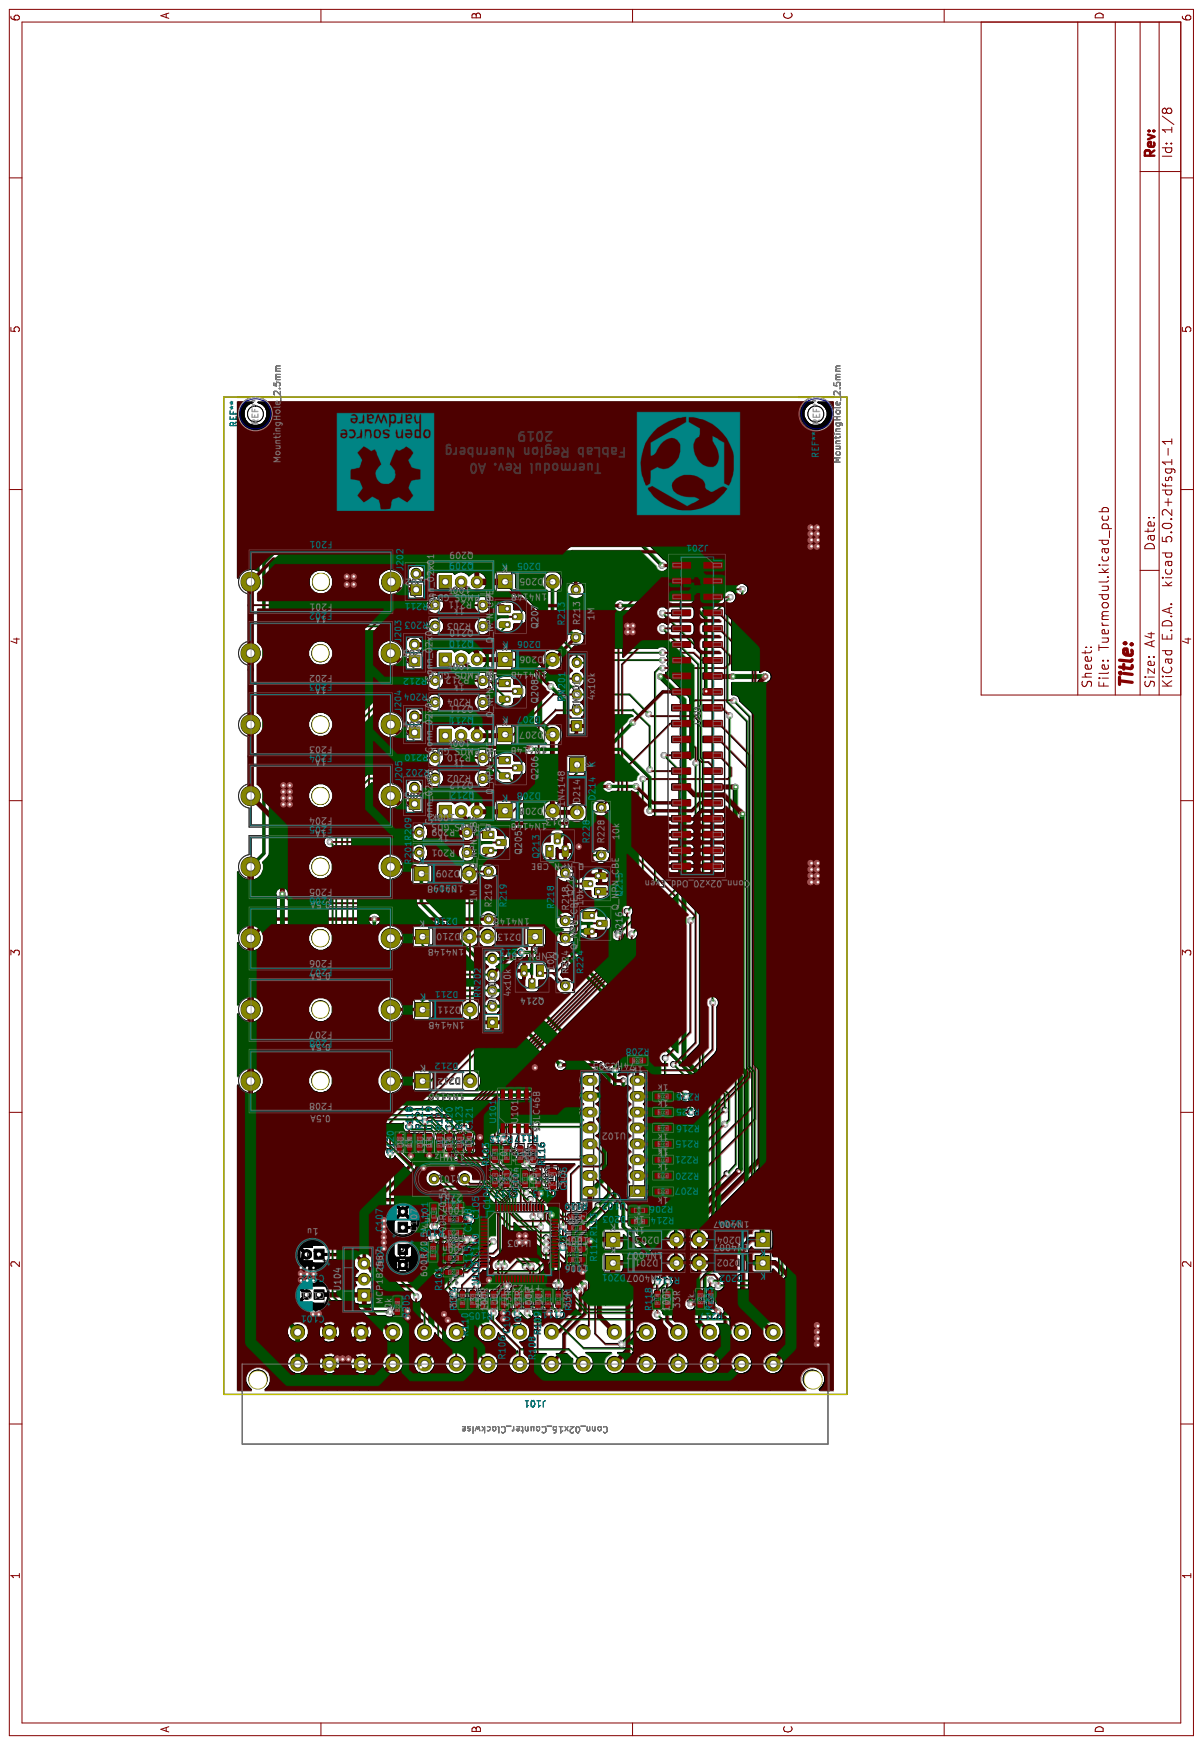
[picture p6: page 1]
