fablabnbg/Innentueren/CAD/Tuermodul/Tuermodul.sch.pdf

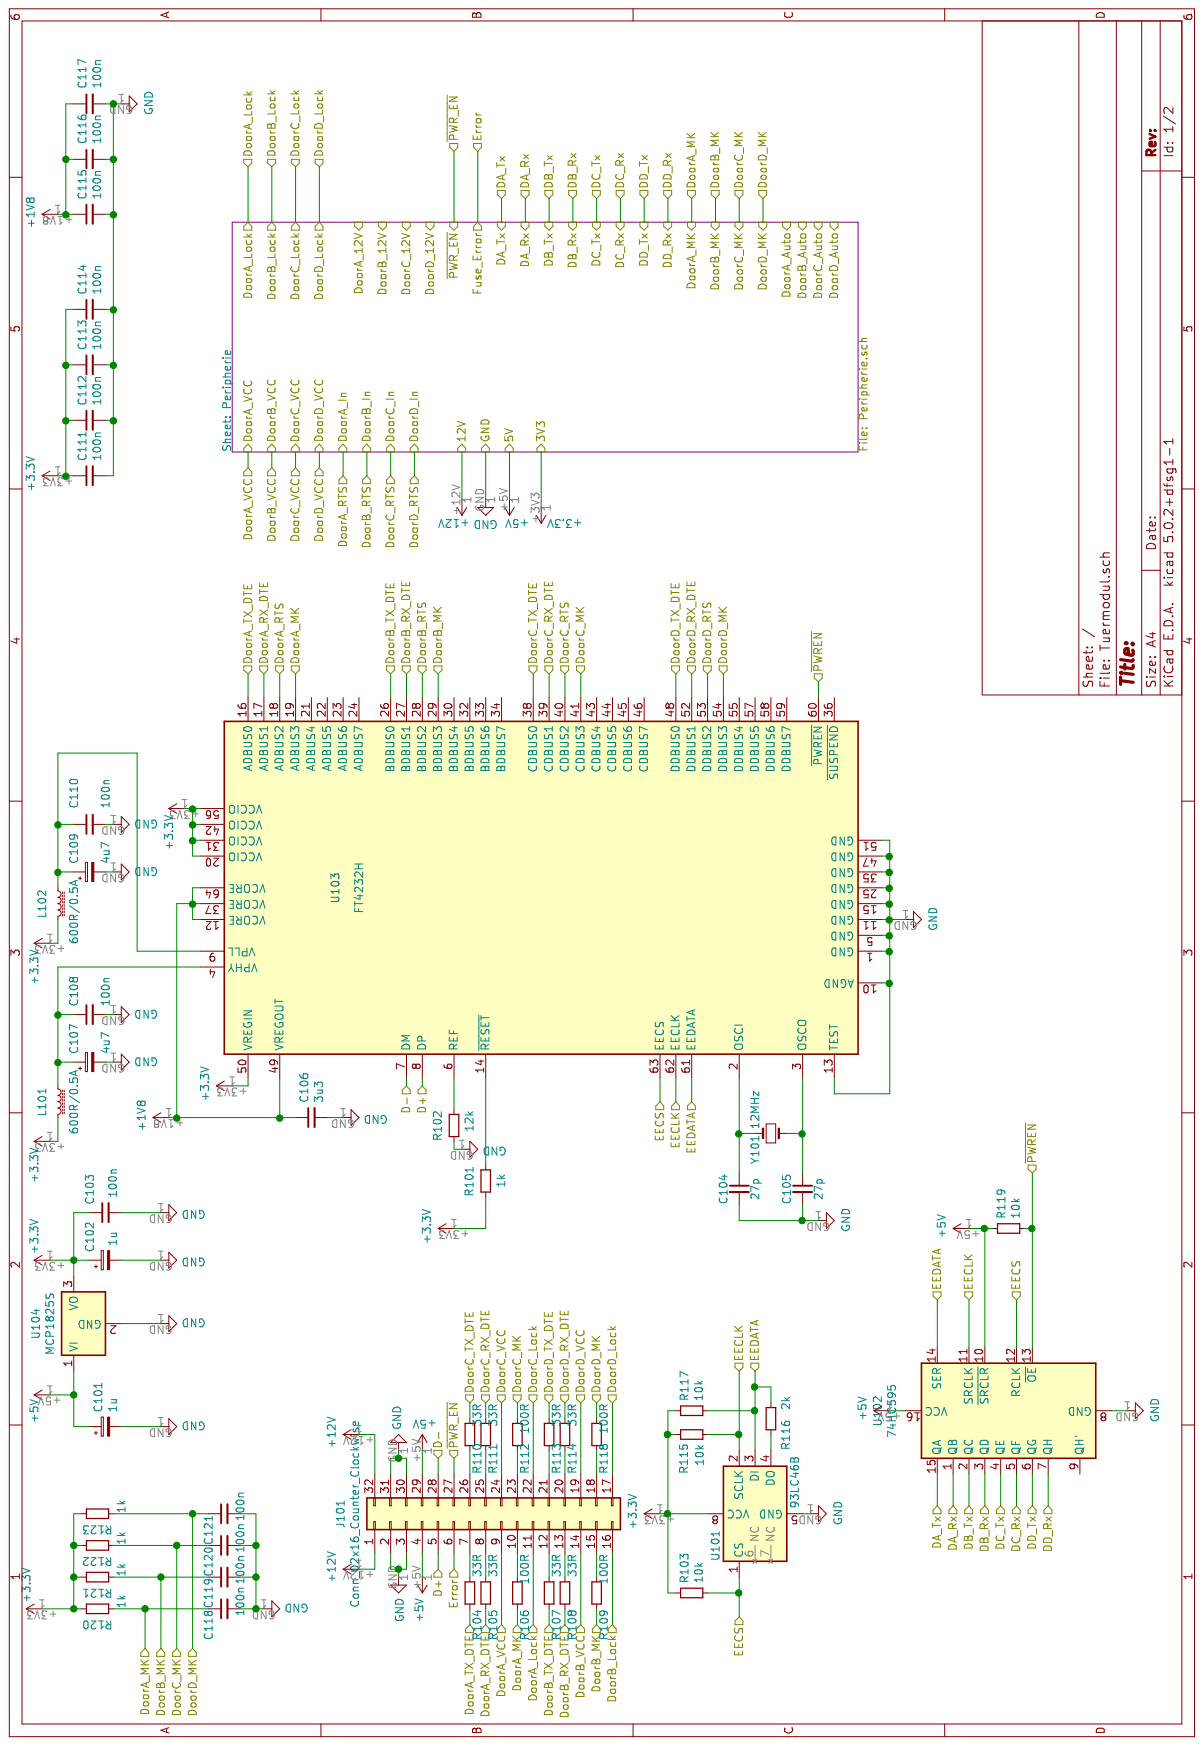
[picture p7: page 1]

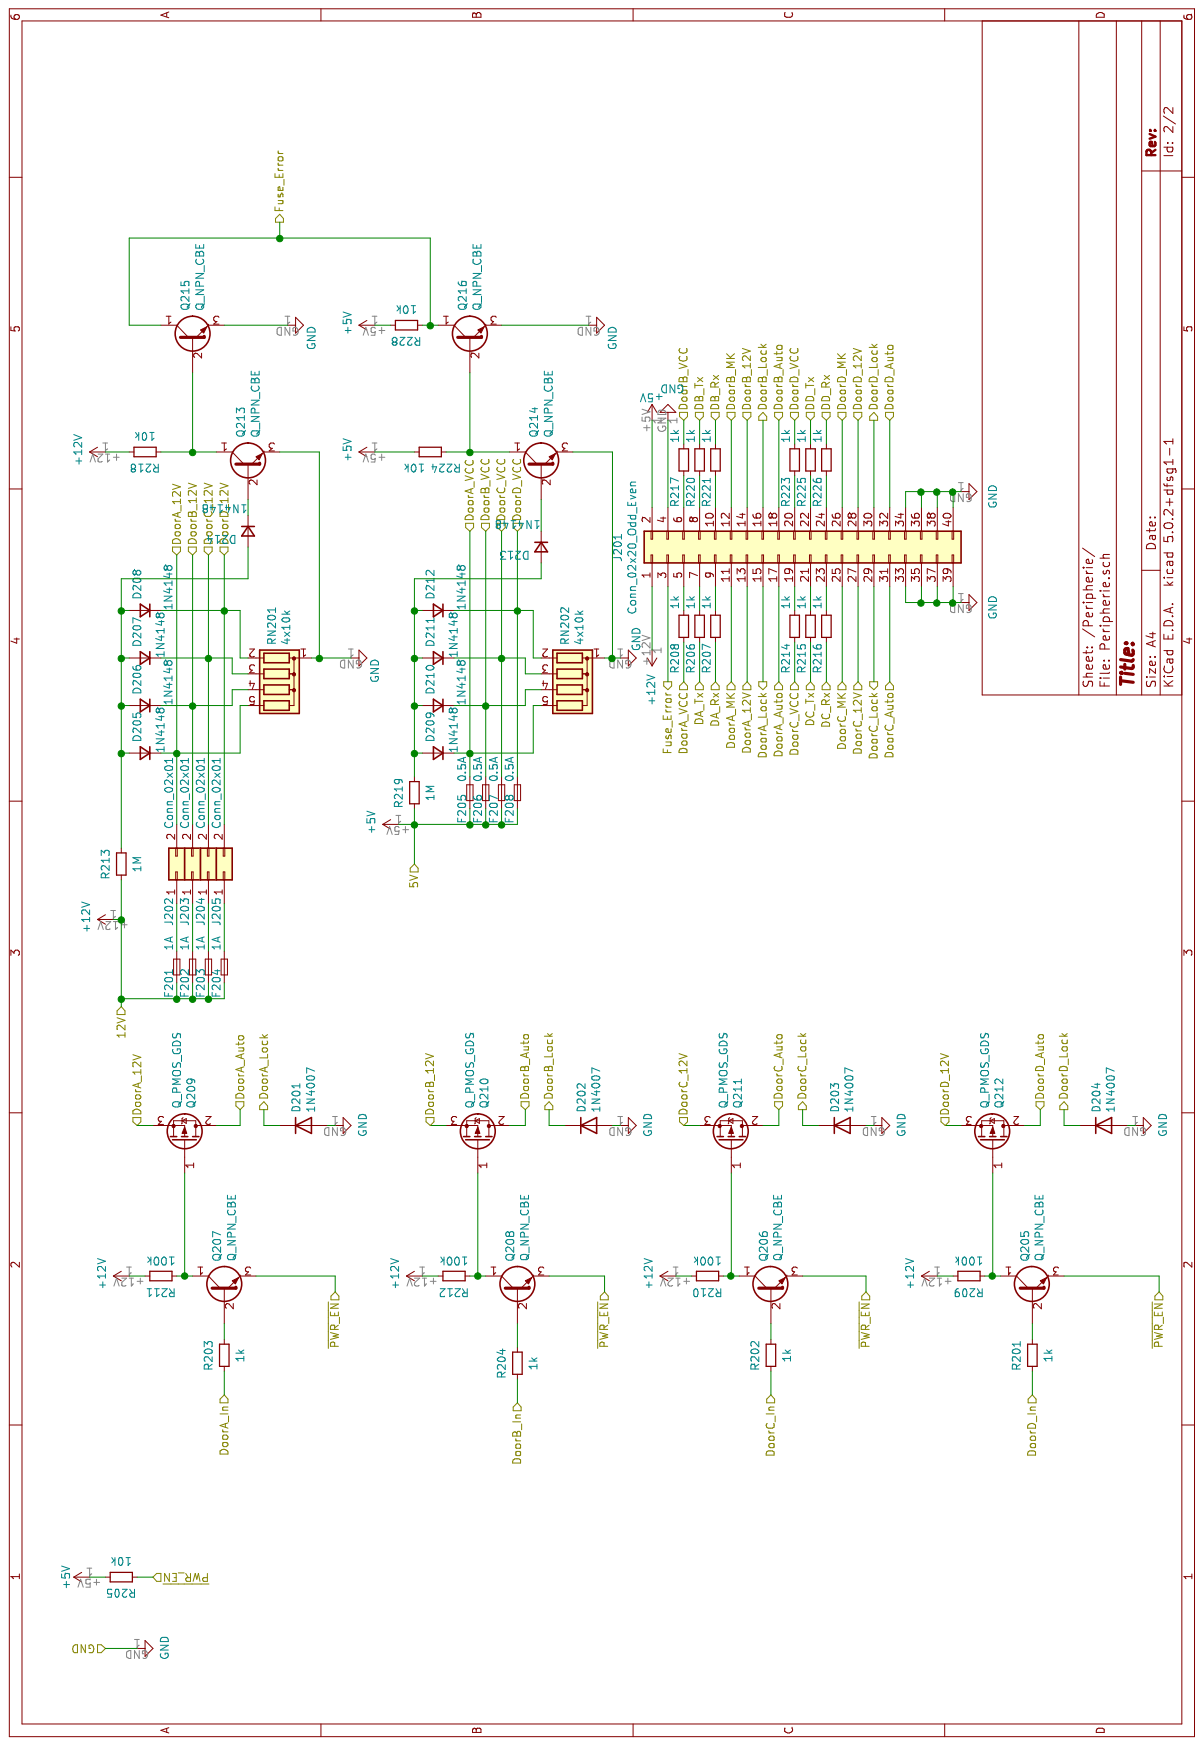
[picture p8: page 2]
