fablabnbg/Innentueren/CAD/Tuermodul_Front/Tuermodul_Front.pcb.pdf

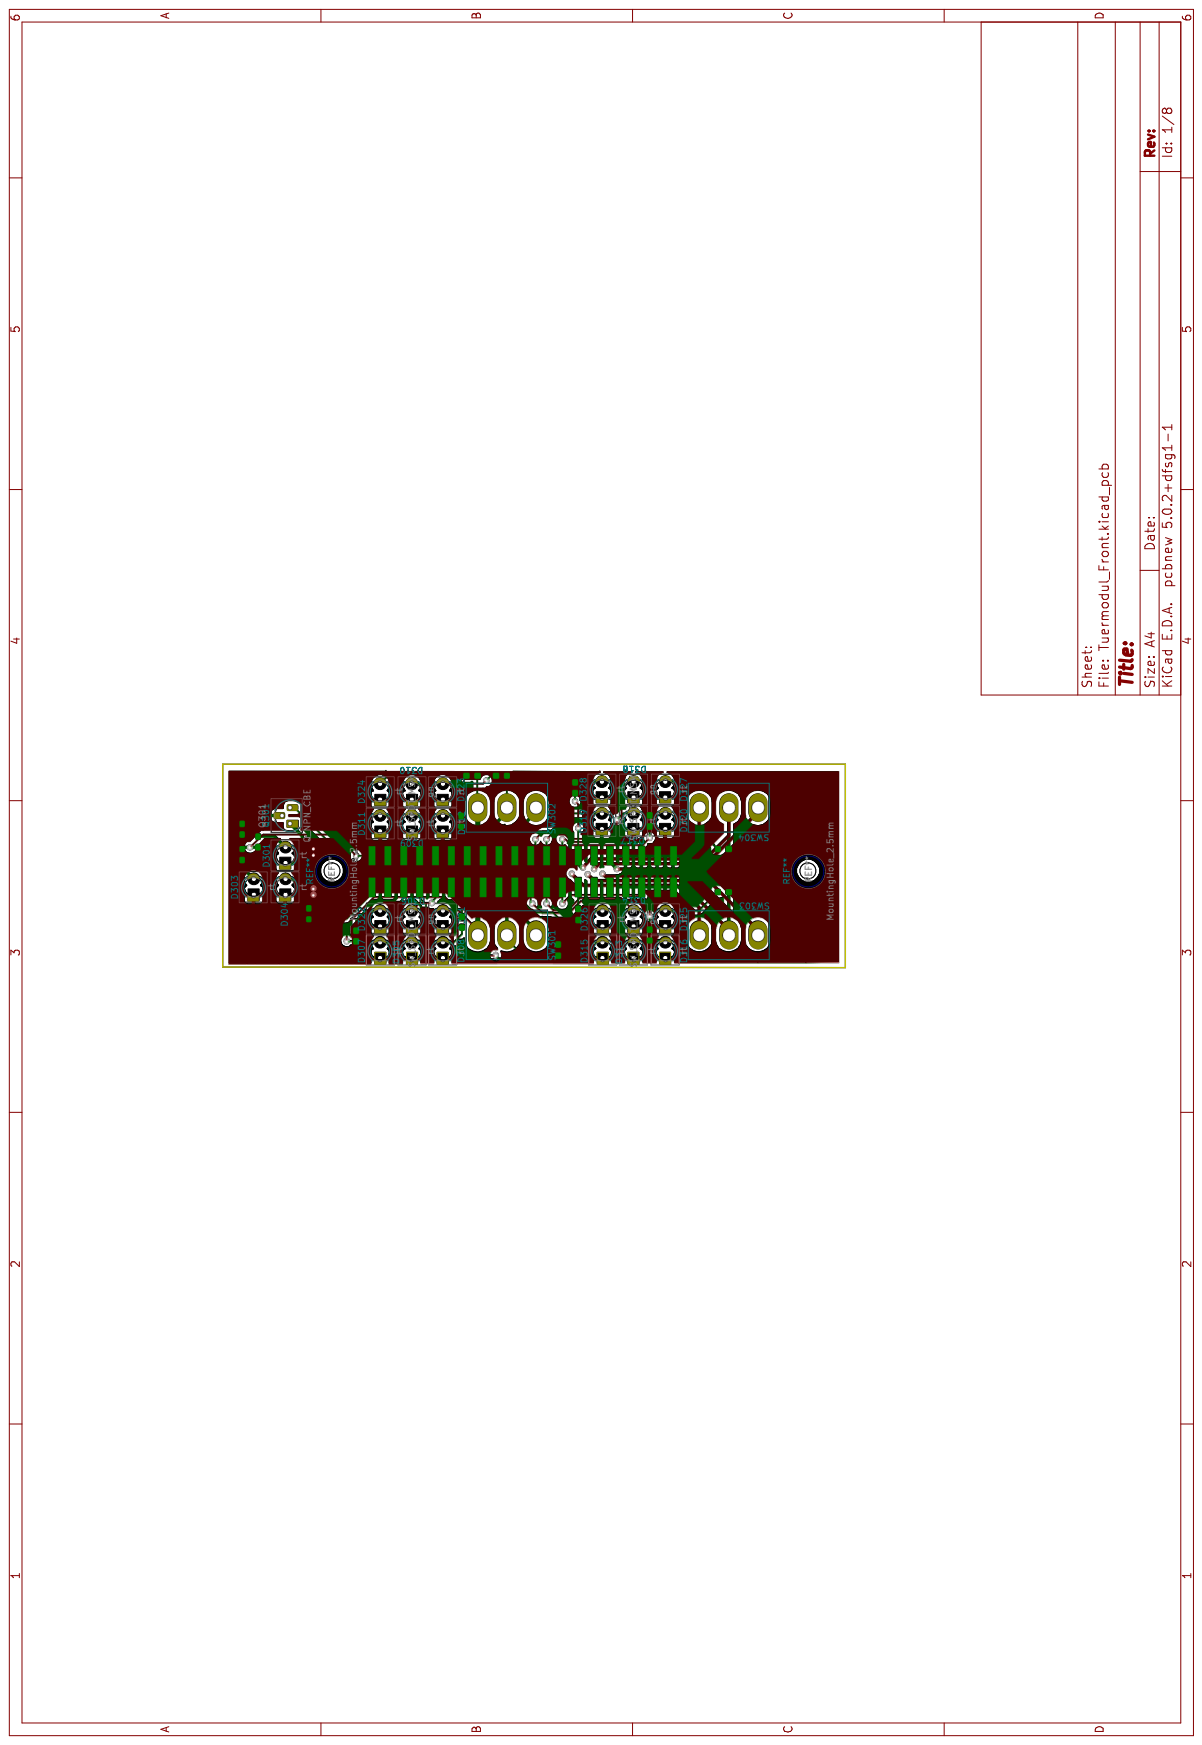
[picture p9: page 1]
