fablabnbg/Innentueren/CAD/Tuermodul_Front/Tuermodul_Front.sch.pdf

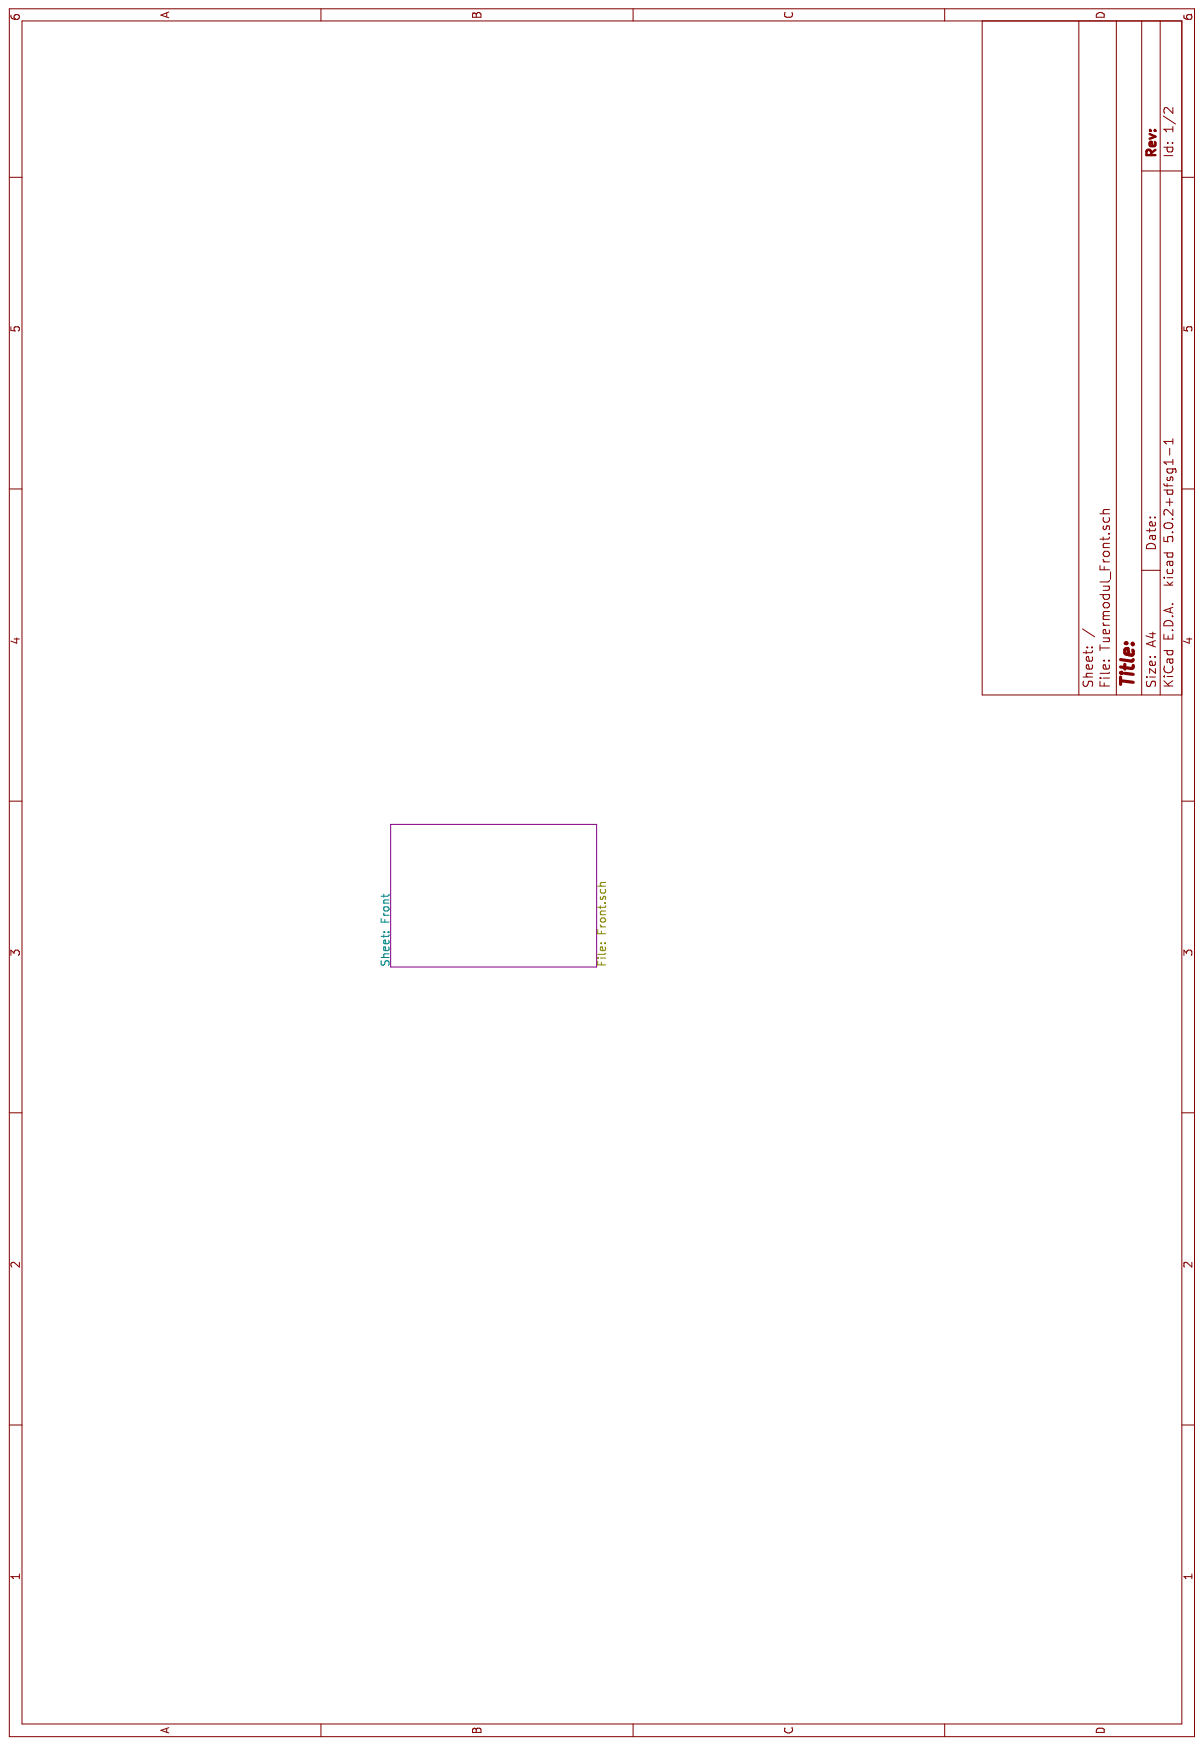
[picture p10: page 1]

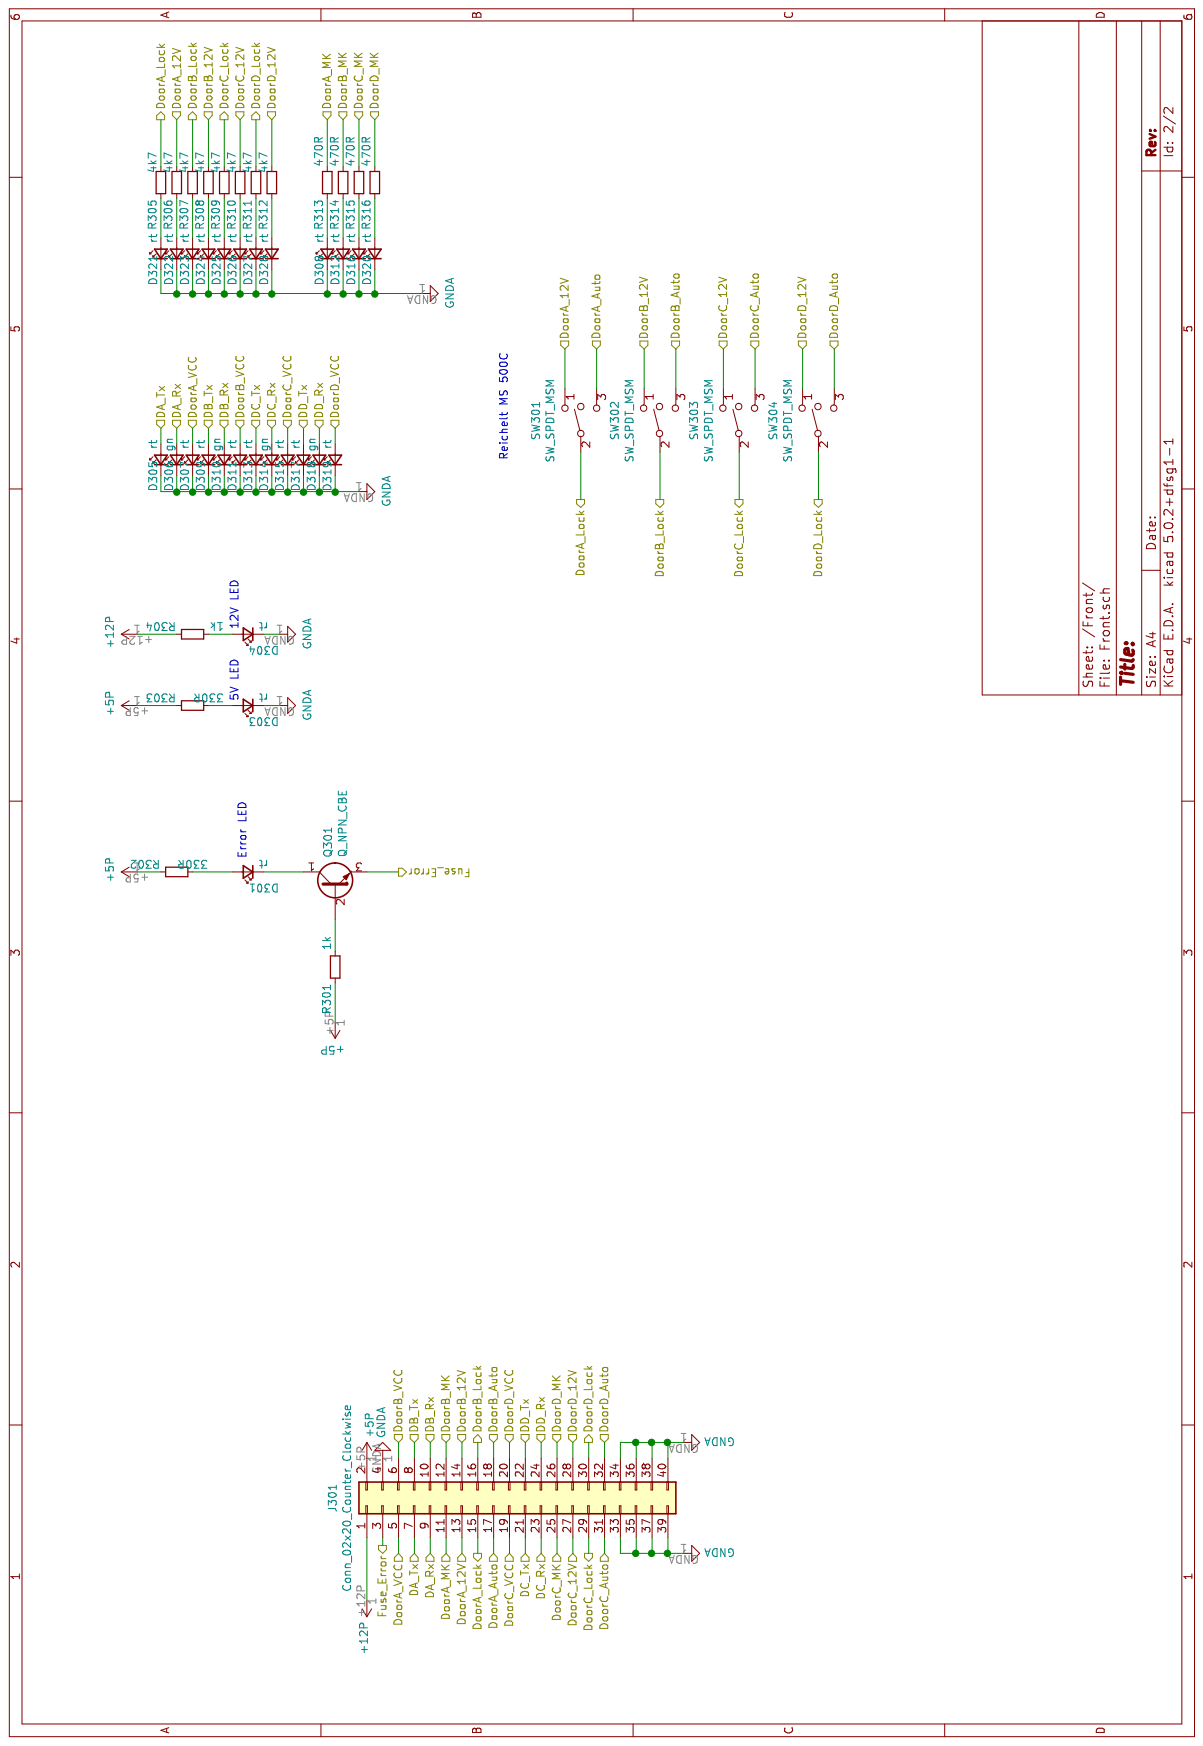
[picture p11: page 2]
