fablabnbg/Innentueren/CAD/Raspi_Innentueren/Raspi_Innentueren.kicad_pcb

## KiCad design CAD/Raspi_Innentueren/Raspi_Innentueren.kicad_pcb (2019-11-11)

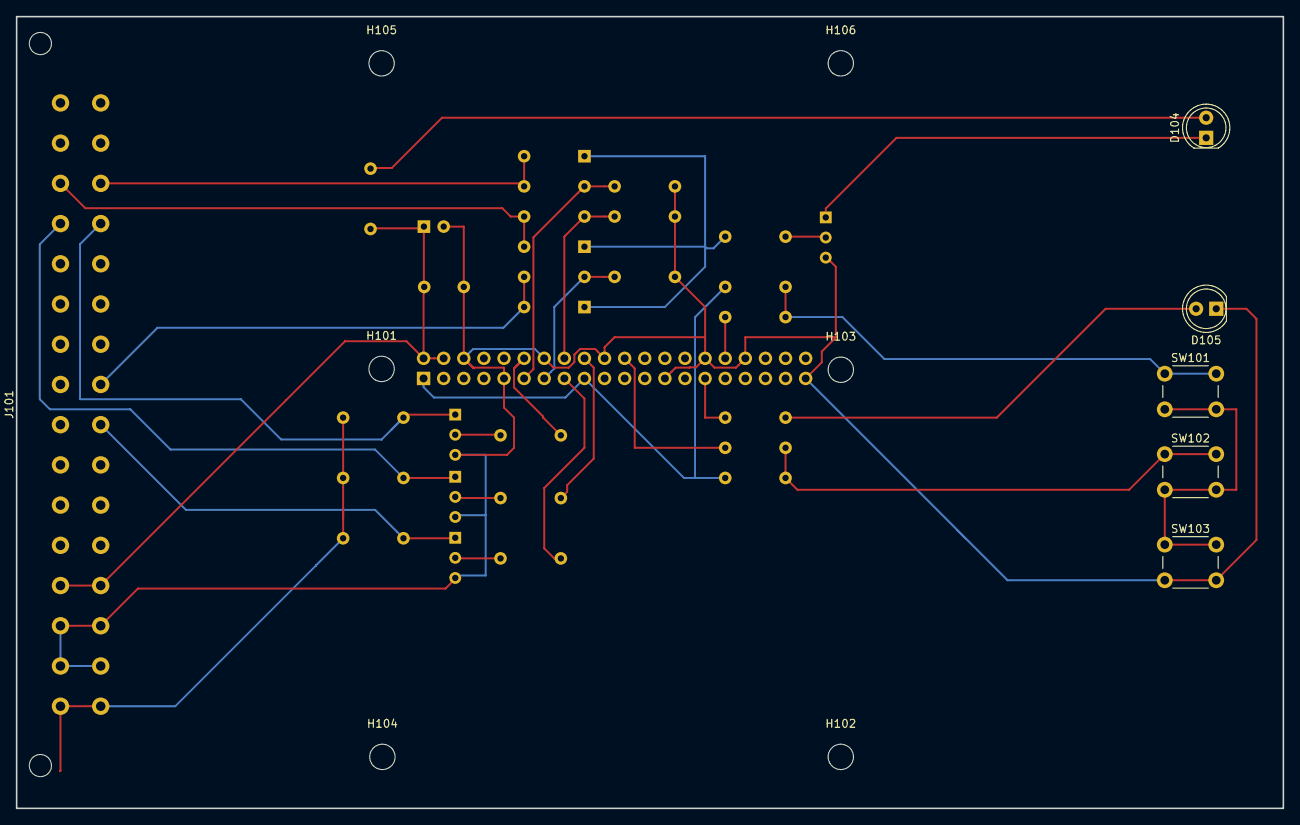
[picture p12: board Raspi_Innentueren.kicad_pcb from above]

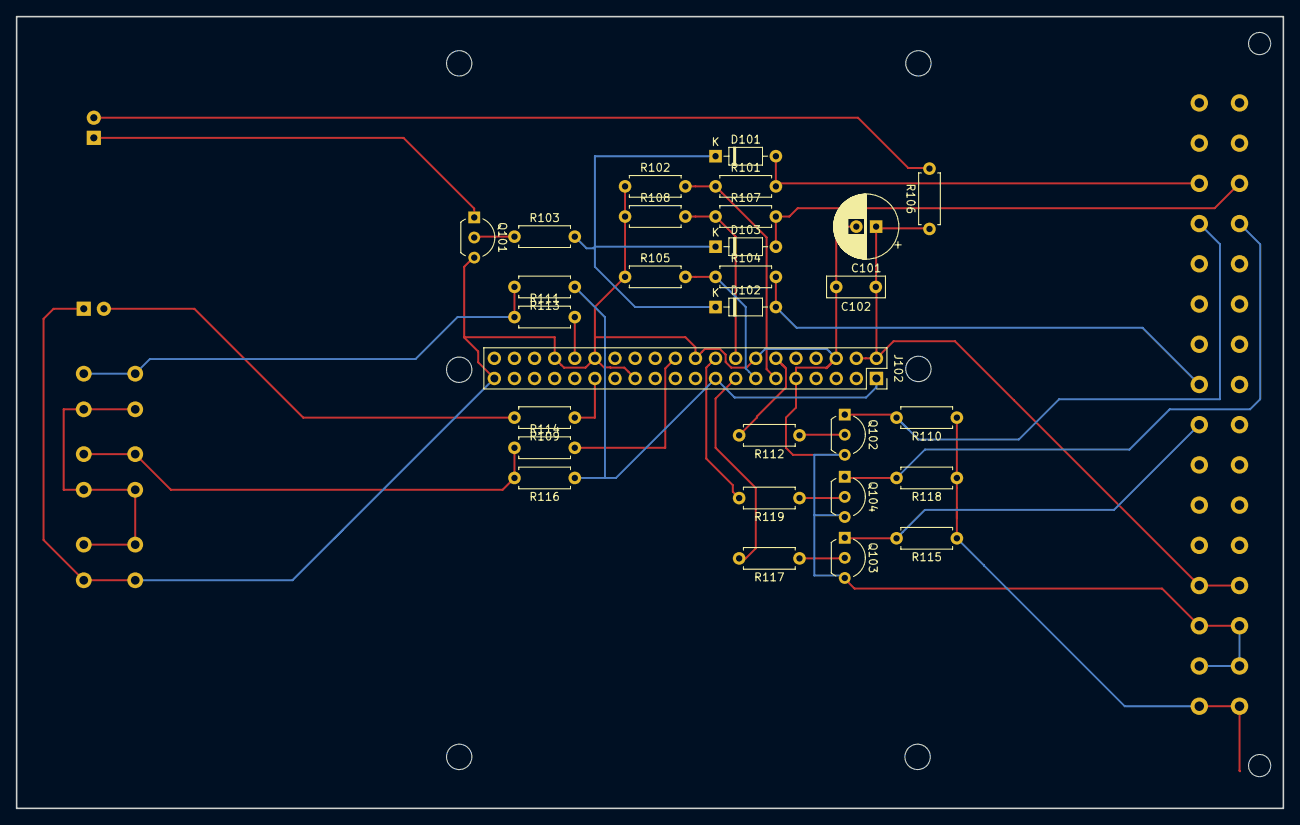
[picture p13: board Raspi_Innentueren.kicad_pcb from below]

Board: 2 copper layers, 160.0 x 100.0 mm, 41 parts (29 on the bottom side), 30 nets.

Parts:
C101: 100u/16V; CP_Radial_D8.0mm_P2.50mm
C102: 100n/16V; C_Rect_L7.2mm_W2.5mm_P5.00mm_FKS2_FKP2_MKS2_MKP2
D101, D102, D103: D_Small; D_DO-35_SOD27_P7.62mm_Horizontal
D104: rt; LED_D5.0mm_Clear
D105: gn; LED_D5.0mm_Clear
H101, H102, H103, H104, H105, H106: MountingHole; MountingHole_3.2mm_M3
J101: Conn_02x16_Letter_AC; DIN41612_D_32pol_90deg
J102: Conn_02x20_Odd_Even; PinSocket_2x20_P2.54mm_Vertical
Q101, Q102, Q103, Q104: Q_NPN_CBE; TO-92L_Inline_Wide
R101, R104, R107: 20k; R_Axial_DIN0207_L6.3mm_D2.5mm_P7.62mm_Horizontal
R102, R105, R108: 39k; R_Axial_DIN0207_L6.3mm_D2.5mm_P7.62mm_Horizontal
R103, R111, R112, R114, R117, R119: 1k; R_Axial_DIN0207_L6.3mm_D2.5mm_P7.62mm_Horizontal
R106: 330R; R_Axial_DIN0207_L6.3mm_D2.5mm_P7.62mm_Horizontal
R109: 120R; R_Axial_DIN0207_L6.3mm_D2.5mm_P7.62mm_Horizontal
R110, R113, R115, R116, R118: 10k; R_Axial_DIN0207_L6.3mm_D2.5mm_P7.62mm_Horizontal
SW101, SW102, SW103: SW_Push; SW_PUSH_6mm

Connections:
+3V3: J102.1, J102.17, R113.1, R116.1
+5V: C101.1, C102.1, J101.26a, J101.26c, J102.2, J102.4, R106.1
+12V: J101.32a, J101.32c, R110.1, R115.1, R118.1
/Run: J102.29, R109.1
/T1_Err_3V3: J102.11, R101.1, R102.2
/T1_Error: D101.2, J101.6a, R101.2
/T1_PWR_EN_3V3: J102.12, R112.2
/T2_Err_3V3: J102.13, R104.1, R105.2
/T2_Error: D102.2, J101.16a, R104.2
/T2_PWR_EN_3V3: J102.15, R117.2
/T3_Err_3V3: J102.16, R107.1, R108.2
/T3_Error: D103.2, J101.6c, R107.2
/T3_PWR_EN_3V3: J102.18, R119.2
/~Check~: J102.32, R111.2
/~Reboot: J102.22, R114.2
/~T1_PWR_EN~: J101.8a, Q102.1, R110.2
/~T2_PWR_EN~: J101.18a, Q103.1, R115.2
/~T3_PWR_EN~: J101.8c, Q104.1, R118.2
GND: C101.2, C102.2, D105.1, J101.28a, J101.28c, J101.30a, J101.30c, J102.6, J102.9, J102.14, J102.20, J102.25, J102.30, J102.34, J102.39, Q101.3, Q102.3, Q103.3, Q104.3, R102.1, R105.1, R108.1, SW103.2
unnamed: D101.1, D102.1, D103.1, R103.2
unnamed: D104.1, Q101.1
unnamed: D104.2, R106.2
unnamed: D105.2, R109.2
unnamed: Q101.2, R103.1
unnamed: Q102.2, R112.1
unnamed: Q103.2, R117.1
unnamed: Q104.2, R119.1
unnamed: R111.1, R113.2, SW101.1
unnamed: R114.1, R116.2, SW102.1
unnamed: SW101.2, SW102.2, SW103.1
