fablabnbg/Innentueren/CAD/Tuermodul_Front/Tuermodul_Front.kicad_pcb

## KiCad design CAD/Tuermodul_Front/Tuermodul_Front.kicad_pcb (2019-04-15)

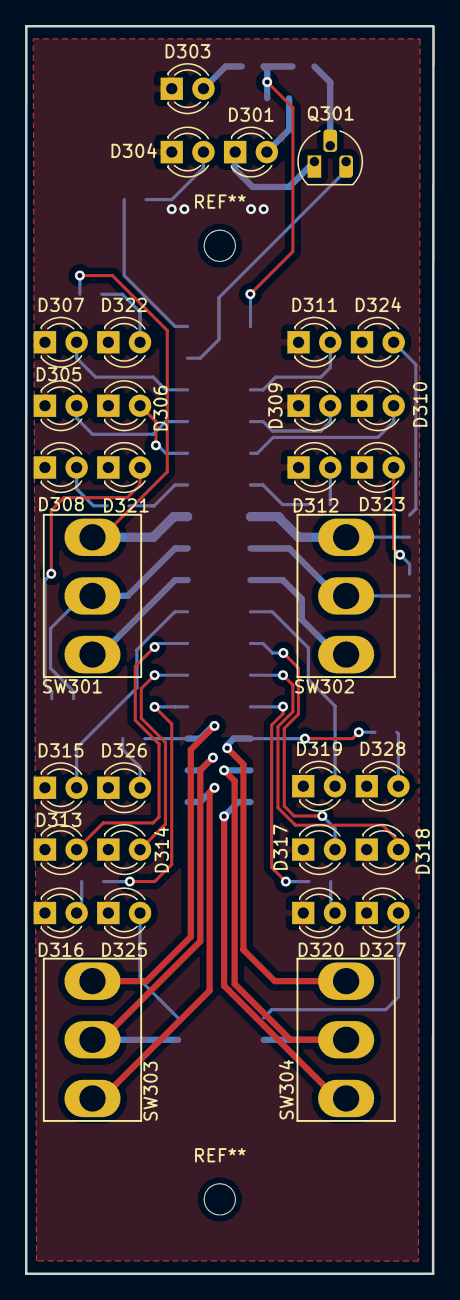
[picture p14: board Tuermodul_Front.kicad_pcb from above]

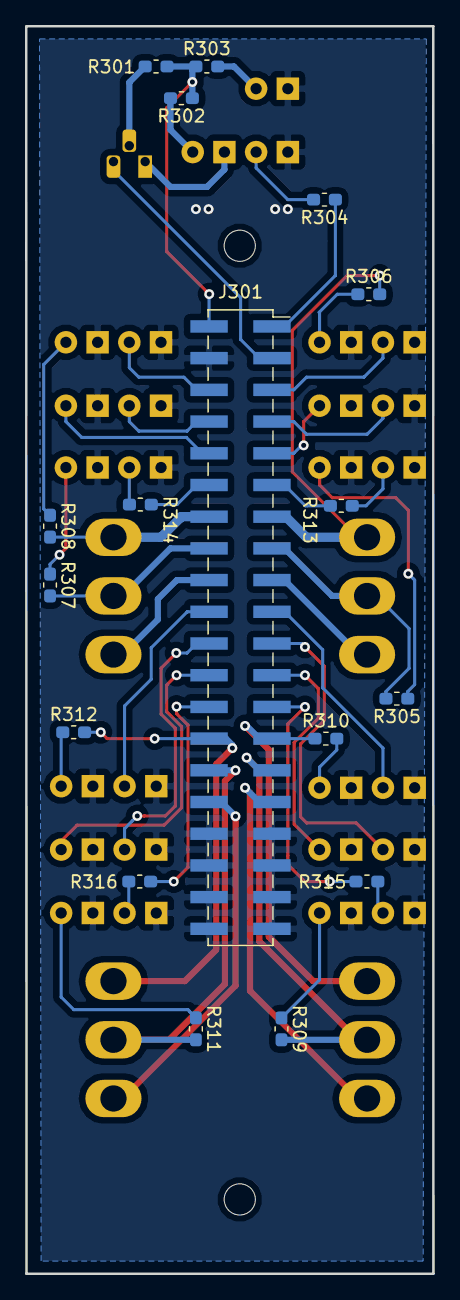
[picture p15: board Tuermodul_Front.kicad_pcb from below]

Board: 2 copper layers, 32.6 x 100.0 mm, 49 parts (17 on the bottom side), 49 nets.

Parts:
D301, D303, D304, D305, D307, D308, D309, D311, D312, D313, D315, D316, D317, D319, D320, D321, D322, D323, D324, D325, D326, D327, D328: rt; LED_D3.0mm
D306, D310, D314, D318: gn; LED_D3.0mm
J301: Conn_02x20_Counter_Clockwise; PinSocket_2x20_P2.54mm_Vertical_SMD
Q301: Q_NPN_CBE; TO-92_HandSolder
R301, R304: 1k; R_0603_1608Metric_Pad1.05x0.95mm_HandSolder
R302, R303: 330R; R_0603_1608Metric_Pad1.05x0.95mm_HandSolder
R305, R306, R307, R308, R309, R310, R311, R312: 4k7; R_0603_1608Metric_Pad1.05x0.95mm_HandSolder
R313, R314, R315, R316: 470R; R_0603_1608Metric_Pad1.05x0.95mm_HandSolder
SW301, SW302, SW303, SW304: SW_SPDT_MSM; SPDT

Connections:
+5P: J301.2, R301.1, R302.1, R303.1
+12P: J301.1, R304.1
/Front/DA_Rx: D306.2, J301.9
/Front/DA_Tx: D305.2, J301.7
/Front/DB_Rx: D310.2, J301.10
/Front/DB_Tx: D309.2, J301.8
/Front/DC_Rx: D314.2, J301.23
/Front/DC_Tx: D313.2, J301.21
/Front/DD_Rx: D318.2, J301.24
/Front/DD_Tx: D317.2, J301.22
/Front/DoorA_12V: J301.13, R306.2, SW301.1
/Front/DoorA_Auto: J301.17, SW301.3
/Front/DoorA_Lock: J301.15, R305.2, SW301.2
/Front/DoorA_MK: J301.11, R313.2
/Front/DoorA_VCC: D307.2, J301.5
/Front/DoorB_12V: J301.14, R308.2, SW302.1
/Front/DoorB_Auto: J301.18, SW302.3
/Front/DoorB_Lock: J301.16, R307.2, SW302.2
/Front/DoorB_MK: J301.12, R314.2
/Front/DoorB_VCC: D311.2, J301.6
/Front/DoorC_12V: J301.27, R310.2, SW303.1
/Front/DoorC_Auto: J301.31, SW303.3
/Front/DoorC_Lock: J301.29, R309.2, SW303.2
/Front/DoorC_MK: J301.25, R315.2
/Front/DoorC_VCC: D315.2, J301.19
/Front/DoorD_12V: J301.28, R312.2, SW304.1
/Front/DoorD_Auto: J301.32, SW304.3
/Front/DoorD_Lock: J301.30, R311.2, SW304.2
/Front/DoorD_MK: J301.26, R316.2
/Front/DoorD_VCC: D319.2, J301.20
/Front/Fuse_Error: J301.3, Q301.3
GNDA: D303.1, D304.1, D305.1, D306.1, D307.1, D308.1, D309.1, D310.1, D311.1, D312.1, D313.1, D314.1, D315.1, D316.1, D317.1, D318.1, D319.1, D320.1, D321.1, D322.1, D323.1, D324.1, D325.1, D326.1, D327.1, D328.1, J301.4, J301.33, J301.34, J301.35, J301.36, J301.37, J301.38, J301.39, J301.40
unnamed: D301.1, Q301.1
unnamed: D301.2, R302.2
unnamed: D303.2, R303.2
unnamed: D304.2, R304.2
unnamed: D308.2, R313.1
unnamed: D312.2, R314.1
unnamed: D316.2, R315.1
unnamed: D320.2, R316.1
unnamed: D321.2, R305.1
unnamed: D322.2, R306.1
unnamed: D323.2, R307.1
unnamed: D324.2, R308.1
unnamed: D325.2, R309.1
unnamed: D326.2, R310.1
unnamed: D327.2, R311.1
unnamed: D328.2, R312.1
unnamed: Q301.2, R301.2
