fablabnbg/Innentueren/CAD/Tuermodul/Tuermodul.kicad_pcb

## KiCad design CAD/Tuermodul/Tuermodul.kicad_pcb (2019-04-15)

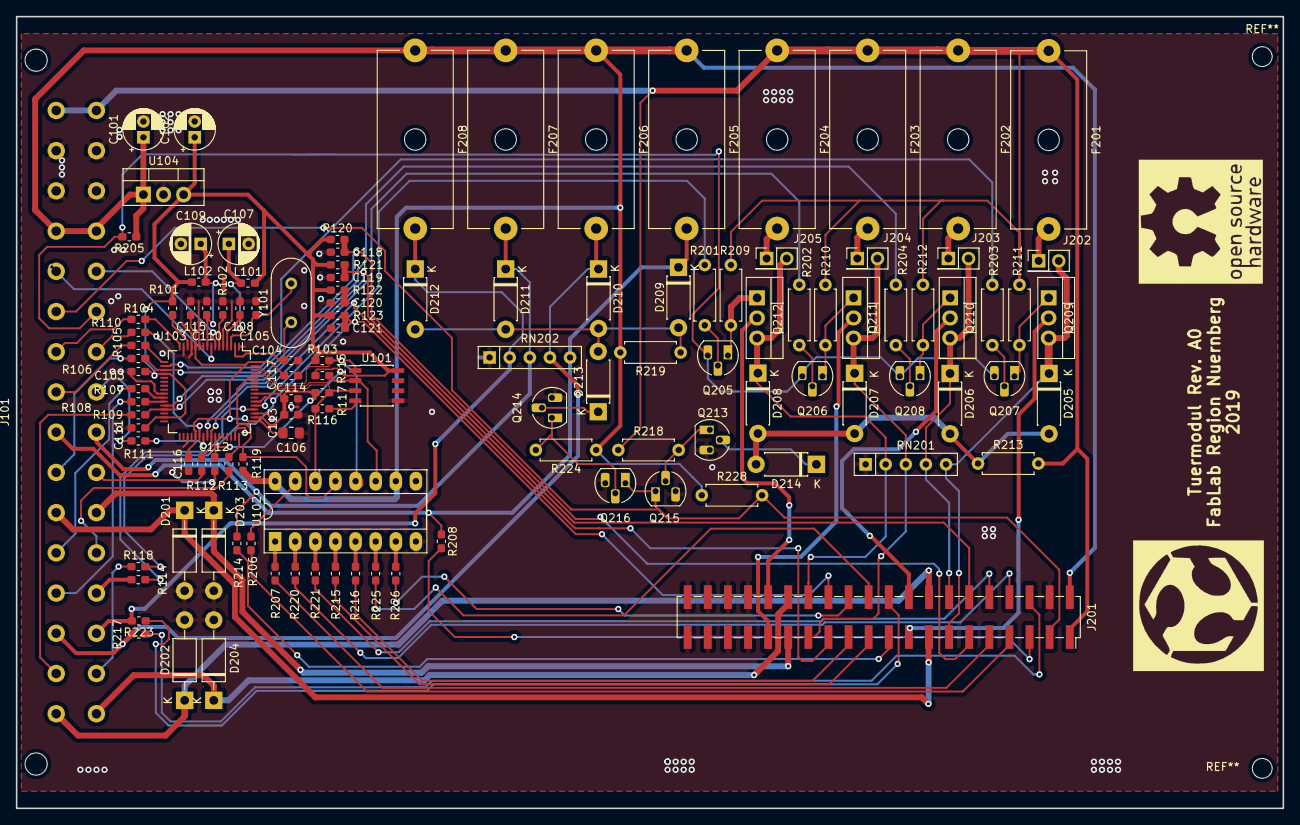
[picture p16: board Tuermodul.kicad_pcb from above]

Board: 2 copper layers, 160.0 x 100.0 mm, 121 parts (0 on the bottom side), 102 nets.

Parts:
C101, C102: 1u; CP_Radial_D5.0mm_P2.00mm
C103, C108, C110, C111, C112, C113, C114, C115, C116, C117, C118, C119, C120, C121: 100n; C_0603_1608Metric_Pad1.05x0.95mm_HandSolder
C104, C105: 27p; C_0603_1608Metric_Pad1.05x0.95mm_HandSolder
C106: 3u3; C_0805_2012Metric_Pad1.15x1.40mm_HandSolder
C107, C109: 4u7; CP_Radial_D5.0mm_P2.50mm
D201, D202, D203, D204: 1N4007; D_DO-41_SOD81_P10.16mm_Horizontal
D205, D206, D207, D208, D209, D210, D211, D212, D213, D214: 1N4148; D_DO-41_SOD81_P7.62mm_Horizontal
F201, F202, F203, F204: 1A; Fuseholder_Cylinder-5x20mm_Schurter_0031_8201_Horizontal_Op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
F205, F206, F207, F208: 0.5A; Fuseholder_Cylinder-5x20mm_Schurter_0031_8201_Horizontal_Op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
G101: LOGO; fln_logo
G102: LOGO; OSH_logo
J101: Conn_02x16_Counter_Clockwise; DIN41612_D_32pol_90deg
J201: Conn_02x20_Odd_Even; PinSocket_2x20_P2.54mm_Vertical_SMD
J202, J203, J204, J205: Conn_02x01; PinHeader_2x01_P2.54mm_Vertical
L101, L102: 600R/0.5A; L_0603_1608Metric_Pad1.05x0.95mm_HandSolder
Q205, Q206, Q207, Q208, Q213, Q214, Q215, Q216: Q_NPN_CBE; TO-92_HandSolder
Q209, Q210, Q211, Q212: Q_PMOS_GDS; TO-220-3_Vertical
R101, R120, R121, R122, R123, R206, R207, R208, R214, R215, R216, R217, R220, R221, R223, R225, R226: 1k; R_0603_1608Metric_Pad1.05x0.95mm_HandSolder
R102: 12k; R_0603_1608Metric_Pad1.05x0.95mm_HandSolder
R103, R115, R117, R119, R205: 10k; R_0603_1608Metric_Pad1.05x0.95mm_HandSolder
R104, R105, R107, R108, R110, R111, R113, R114: 33R; R_0603_1608Metric_Pad1.05x0.95mm_HandSolder
R106, R109, R112, R118: 100R; R_0603_1608Metric_Pad1.05x0.95mm_HandSolder
R116: 2k; R_0603_1608Metric_Pad1.05x0.95mm_HandSolder
R201, R202, R203, R204: 1k; R_Axial_DIN0207_L6.3mm_D2.5mm_P7.62mm_Horizontal
R209, R210, R211, R212: 100k; R_Axial_DIN0207_L6.3mm_D2.5mm_P7.62mm_Horizontal
R213, R219: 1M; R_Axial_DIN0207_L6.3mm_D2.5mm_P7.62mm_Horizontal
R218, R224, R228: 10k; R_Axial_DIN0207_L6.3mm_D2.5mm_P7.62mm_Horizontal
RN201, RN202: 4x10k; R_Array_SIP5
U101: 93LC46B; SOIC-8_3.9x4.9mm_P1.27mm
U102: 74HC595; DIP-16_W7.62mm_Socket_LongPads
U103: FT4232H; LQFP-64_10x10mm_P0.5mm
U104: MCP1825S; TO-220-3_Vertical
Y101: 12MHz; Crystal_HC18-U_Vertical

Connections:
+1V8: C106.1, C115.1, C116.1, C117.1, U103.12, U103.37, U103.49, U103.64
+3V3: C102.1, C103.1, C111.1, C112.1, C113.1, C114.1, L101.2, L102.2, R101.1, R103.1, R115.1, R117.1, R120.1, R121.1, R122.1, R123.1, U101.8, U103.20, U103.31, U103.42, U103.50, U103.56, U104.3
+5V: C101.1, F205.1, F206.1, F207.1, F208.1, J101.4, J101.29, J201.2, R119.1, R205.1, R219.2, R224.1, R228.1, U102.10, U102.16, U104.1
+12V: F201.1, F202.1, F203.1, F204.1, J101.1, J101.32, J201.1, R209.2, R210.2, R211.2, R212.2, R213.2, R218.1
/D+: J101.5, U103.8
/D-: J101.28, U103.7
/DA_Rx: R207.1, U102.1
/DA_Tx: R206.1, U102.15
/DB_Rx: R221.2, U102.3
/DB_Tx: R220.2, U102.2
/DC_Rx: R216.1, U102.5
/DC_Tx: R215.1, U102.4
/DD_Rx: R226.2, U102.7
/DD_Tx: R225.2, U102.6
/DoorA_Lock: D201.1, J101.11, J201.15
/DoorA_MK: C118.1, J201.11, R106.1, R120.2, U103.19
/DoorA_RTS: R203.2, U103.18
/DoorA_RX_DTE: R105.1, U103.17
/DoorA_TX_DTE: R104.1, U103.16
/DoorA_VCC: D209.1, F205.2, J101.9, R208.1, RN202.5
/DoorB_Lock: D202.1, J101.16, J201.16
/DoorB_MK: C119.1, J201.12, R109.1, R121.2, U103.29
/DoorB_RTS: R204.2, U103.28
/DoorB_RX_DTE: R108.1, U103.27
/DoorB_TX_DTE: R107.1, U103.26
/DoorB_VCC: D210.1, F206.2, J101.14, R217.2, RN202.4
/DoorC_Lock: D203.1, J101.22, J201.29
/DoorC_MK: C120.1, J201.25, R112.2, R122.2, U103.41
/DoorC_RTS: R202.2, U103.40
/DoorC_RX_DTE: R111.2, U103.39
/DoorC_TX_DTE: R110.2, U103.38
/DoorC_VCC: D211.1, F207.2, J101.24, R214.1, RN202.3
/DoorD_Lock: D204.1, J101.17, J201.30
/DoorD_MK: C121.1, J201.26, R118.2, R123.2, U103.54
/DoorD_RTS: R201.2, U103.53
/DoorD_RX_DTE: R114.2, U103.52
/DoorD_TX_DTE: R113.2, U103.48
/DoorD_VCC: D212.1, F208.2, J101.19, R223.2, RN202.2
/EECLK: R115.2, U101.2, U102.11, U103.62
/EECS: R103.2, U101.1, U102.12, U103.63
/EEDATA: R116.2, R117.2, U101.3, U102.14, U103.61
/Error: J101.6, J201.3, Q215.1, Q216.1, R228.2
/Peripherie/DoorA_12V: D205.1, J201.13, J202.2, Q209.3, RN201.5
/Peripherie/DoorA_Auto: J201.17, Q209.2
/Peripherie/DoorB_12V: D206.1, J201.14, J203.2, Q210.3, RN201.4
/Peripherie/DoorB_Auto: J201.18, Q210.2
/Peripherie/DoorC_12V: D207.1, J201.27, J204.2, Q211.3, RN201.3
/Peripherie/DoorC_Auto: J201.31, Q211.2
/Peripherie/DoorD_12V: D208.1, J201.28, J205.2, Q212.3, RN201.2
/Peripherie/DoorD_Auto: J201.32, Q212.2
/~PWREN~: R119.2, U102.13, U103.60
/~PWR_EN~: J101.27, Q205.3, Q206.3, Q207.3, Q208.3, R205.2
GND: C101.2, C102.2, C103.2, C104.2, C105.2, C106.2, C107.2, C108.2, C109.2, C110.2, C111.2, C112.2, C113.2, C114.2, C115.2, C116.2, C117.2, C118.2, C119.2, C120.2, C121.2, D201.2, D202.2, D203.2, D204.2, J101.2, J101.3, J101.30, J101.31, J201.4, J201.33, J201.34, J201.35, J201.36, J201.37, J201.38, J201.39, J201.40, Q213.3, Q214.3, Q215.3, Q216.3, R102.1, RN201.1, RN202.1, U101.5, U102.8, U103.1, U103.5, U103.10, U103.11, U103.13, U103.15, U103.25, U103.35, U103.47, U103.51, U104.2
unnamed: C104.1, U103.2, Y101.1
unnamed: C105.1, U103.3, Y101.2
unnamed: C107.1, C108.1, L101.1, U103.4
unnamed: C109.1, C110.1, L102.1, U103.9
unnamed: D205.2, D206.2, D207.2, D208.2, D214.2, R213.1
unnamed: D209.2, D210.2, D211.2, D212.2, D213.2, R219.1
unnamed: D213.1, Q214.2
unnamed: D214.1, Q213.2
unnamed: F201.2, J202.1
unnamed: F202.2, J203.1
unnamed: F203.2, J204.1
unnamed: F204.2, J205.1
unnamed: J101.7, R104.2
unnamed: J101.8, R105.2
unnamed: J101.10, R106.2
unnamed: J101.12, R107.2
unnamed: J101.13, R108.2
unnamed: J101.15, R109.2
unnamed: J101.18, R118.1
unnamed: J101.20, R114.1
unnamed: J101.21, R113.1
unnamed: J101.23, R112.1
unnamed: J101.25, R111.1
unnamed: J101.26, R110.1
unnamed: J201.5, R208.2
unnamed: J201.6, R217.1
unnamed: J201.7, R206.2
unnamed: J201.8, R220.1
unnamed: J201.9, R207.2
unnamed: J201.10, R221.1
unnamed: J201.19, R214.2
unnamed: J201.20, R223.1
unnamed: J201.21, R215.2
unnamed: J201.22, R225.1
unnamed: J201.23, R216.2
unnamed: J201.24, R226.1
unnamed: Q205.1, Q212.1, R209.1
unnamed: Q205.2, R201.1
unnamed: Q206.1, Q211.1, R210.1
unnamed: Q206.2, R202.1
unnamed: Q207.1, Q209.1, R211.1
unnamed: Q207.2, R203.1
unnamed: Q208.1, Q210.1, R212.1
unnamed: Q208.2, R204.1
unnamed: Q213.1, Q215.2, R218.2
unnamed: Q214.1, Q216.2, R224.2
unnamed: R101.2, U103.14
unnamed: R102.2, U103.6
unnamed: R116.1, U101.4
