fablabnbg/Innentueren/(commit log)

2019-01-22 -mod: first commit of schematic and layout
    [Peripherie.sch, Tuermodul.kicad_pcb, Tuermodul.sch]
2019-01-29 -add: Fuse Error, missing LEDs -mod: some Resistor footprints changed -mod: first placement in layout
    [Peripherie.sch, Tuermodul.kicad_pcb, Tuermodul.sch]
2019-01-31 -add: Front.sch for front panel -mod: moved leds and switches to front panel -mod: added MK contacts (not finished jet) -mod: added switches
    [Front.sch, Peripherie.sch, Tuermodul.sch]
2019-02-07 Arduino-Project for the MFRC522 RFID Cardreader
2019-02-08 -add: Kartenleser Doku -mod: Cardreader_522 made changes sugested by Patrick H. -mod: Cardreader_522 added some comments -mod: Cardreader_522 corrected Commnts regarding LED colors
    [Leserbefehle.ods]
2019-02-08 -mod Cardreader_522: Fixed wrong shift
    [Cardreader_522.ino]
2019-02-09 -mod Fixed Race condition (atmega328 has no 8bit increment / decrement commands)
    [Cardreader_522.ino]
2019-02-10 -add: switch library for spdt switches -mod: improvements in schematic, bugfixes -mod: placement and routing of the ftdi chip + chicken food
    [Front.sch, Peripherie.sch, Tuermodul.kicad_pcb, Tuermodul.sch]
2019-02-10 -add Cardreader_532 Arduino Programm
2019-02-13 -mod: layout tuermodul
    [Tuermodul.kicad_pcb, Tuermodul.sch]
2019-02-15 -mod Cleanup Cardreader_522 Software -mod Add Hardware Reset to Reader in Cardreader_522 Software
    [Cardreader_532.ino]
2019-02-16 -mod: adapted TechSpec due to power enable discussion -mod: changed pin header for front-to-main panel connection -mod: general layout work
    [Front.sch, Peripherie.sch, Tuermodul.kicad_pcb, Tuermodul.sch]
2019-03-07 mod:layout work
    [Tuermodul.kicad_pcb]
2019-03-10 -mod: Umbelegung Stecker zwischen Haupt und Frontplatine -add: 100n caps für MK Entprellung -mod: Routing Stecker -mod: Platzierung Front nach Vorgabe
    [Front.sch, Peripherie.sch, Tuermodul.kicad_pcb, Tuermodul.sch]
2019-03-13 -mod: layout update from 10.03.19
    [Tuermodul.kicad_pcb]
2019-03-26 -mod: Änderungen aus Review in Schaltplan und Layout
    [Front.sch, Peripherie.sch, Tuermodul.kicad_pcb, Tuermodul.sch]
2019-03-29 -mod: DIN Stecker auf Typ D geändert. Layout angepasst und optimiert.
    [Tuermodul.kicad_pcb, Tuermodul.sch]
2019-03-31 -add: BOM -mod: letzte Schritte für LP Hersteller, Gerber Dateien für A0 generiert.
    [Front.sch, Tuermodul.kicad_pcb, Tuermodul.ods]
2019-04-15 -mod: Front und Hauptplatine separiert -mod: BOM von Nicolas überarbeitet
    [Front.sch, Peripherie.sch, Tuermodul.kicad_pcb, Tuermodul.ods, Tuermodul.sch, Tuermodul_Front.kicad_pcb, Tuermodul_Front.sch]
2019-04-24 -BOM: Teile rausgesucht.
    [Tuermodul.ods]
2019-10-14 -add: KiCAD project Raspi Innentueren
    [Raspi_Innentueren.kicad_pcb, Raspi_Innentueren.sch]
2019-10-14 -mod: bugfixed mounting holes
2019-10-16 -bug: fixed bugs in raspi schematic -mod: added confirm button and additional check button -mod: PWR_EN signals shifted from 3V3 to 12V level via transistor
    [Raspi_Innentueren.kicad_pcb, Raspi_Innentueren.sch]
2019-11-04 -mod: layout Raspi Platine fertiggestellt
    [Raspi_Innentueren.kicad_pcb]
2019-11-04 -mod: raspi stecker nach oben und links verschoben, mountingholes hinzugefügt
    [Raspi_Innentueren.kicad_pcb, Raspi_Innentueren.sch]
2019-11-11 -mod: update shield layout
    [Raspi_Innentueren.kicad_pcb]
2020-03-15 -add: Mechanik für Kartenleser hinzugefuegt
    [KartenleserSCAD.scad, KartenleserSCAD.stl, Tuermodul.ods]
2021-07-04 PDF-Files for schematics and pcbs Signed-off-by: Juergen G. Schimmer <schimmi2@gmail.com>
2021-12-06 exercising filter, to access a specific list of items from an app... We can use that to query only those items from te Mitglieder app that are referenced by an NFC item.
